netnis22/project-alset/test 1/Road2.jpg

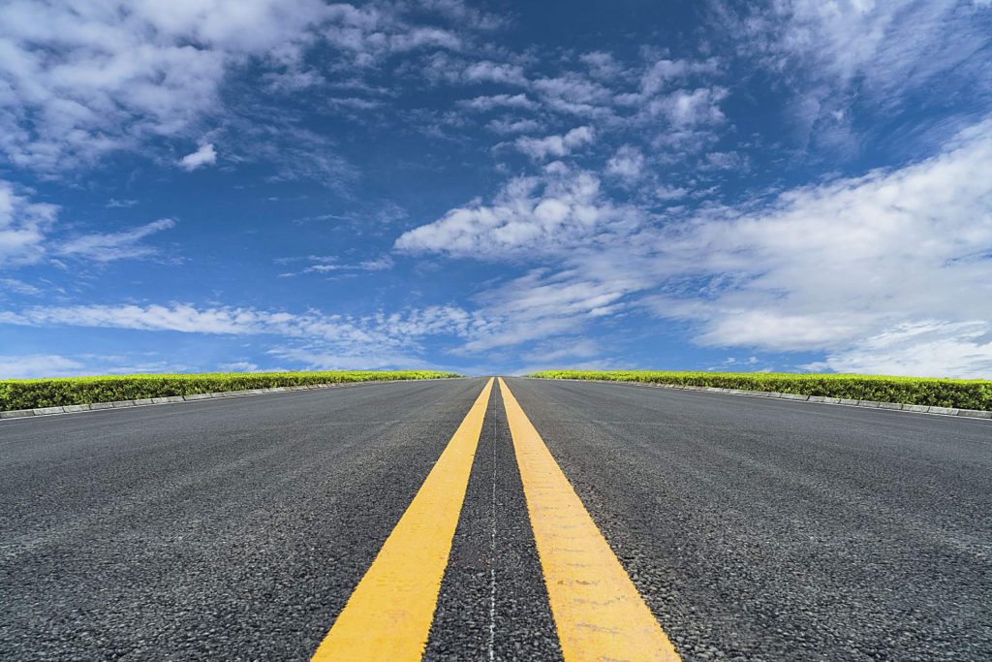
test 1/Road2.jpg
