netnis22/project-alset/test 1/imgRoodP.jpg

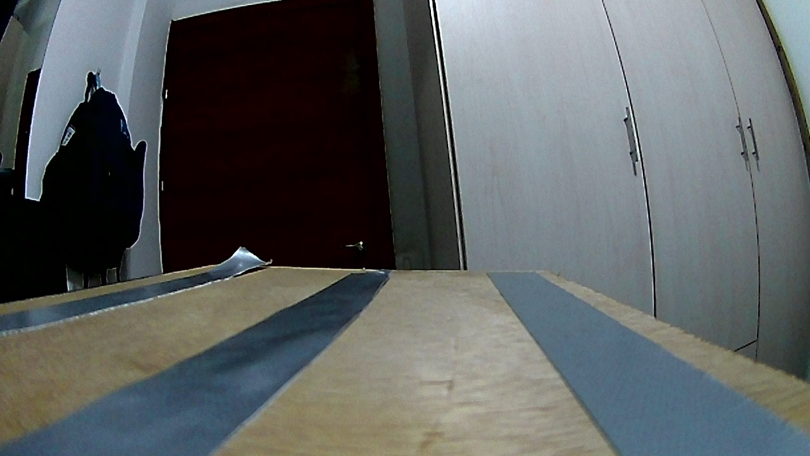
test 1/imgRoodP.jpg
