netnis22/project-alset/ספר פרויקט.pdf

# הלסט - alset

## שם בית ספר: אורט רבין גן יבנה שם המנחה: משה זזק שם החלופה: הגנת סייבר

## מגישים: נתנאל חכמון324199504- אייל גלם325754919-תאריך הגשה8/6/2021:

# תוכן עניינים

תקציר | 2..

## מבוא | 3-5 ארכיטקטורה | 6-11

מדריך למשתמש | 12-16.
מדריך למפתח | 17-34....
רפלקציה נתנאל | 35..
רפלקציה אייל | 36.
ביבליוגרפיה | 37...
נספחים | 38-52..

# תקציר

הפרויקט שלנו הוא דגם של מכונית אוטונומית המשלבת אלקטרוניקה,פיזיקה,מכניקה ותוכנה. מטרת הפרויקט היא לזהות את השוליים של הכביש ולתת פקודה לרכב לנוע בכיוון של הכביש בלי סטיה מהמסלול.

בספר זה אנו נסביר על הפרויקט , על אך הוא עובד , על האלקטרוניקה שלו, על המחשבה של איך ליבנות פיזית את הרובוט, על כל החישובים הפיזיקליים, על האלגוריתם של המציית השוליים של הכביש, על התקשורת בין החלקים השונים ועל הסיבה שבגללה בחרנו בפרויקט זה.

# מבוא

ספר זה מורכב מכמה חלקים חלק ראשון תקציר אשר מטרתו היא להסביר בקצרה על הספר ועל הפרויקט.

חלק שני הוא המבוא שבחלק זה אנו מרחיבים את אמירותיו בתקציר בנוסף לכך אנו מוסיפים את תהליך המחקר של הפרויקט,האתגרים שהיו לנו בפרויקט ופתרונות לבעית הללו.

חלק שלישי הוא הארכיטקטורה ששם אנו מסבירים על הפרויקט עצמו לעומק, מציגים את הפתרון הסופי שבו השתמשו למציאת הבעיה שמוזכרת במבוא, את הארכיטקטורה של הפתרון, בחלק זה אנו גם מסבירים גם על כל חלק אלקטרוני ברובוט ומה תפקידו, שרטוטים של האלקטרוניקה , נסביר גם על הקוד שכתבנו למציאת השוליים, נסביר על הספריות שהשתמשו בהם, נסביר על הקוד של הרובוט ועל הקוד השולט ומתרגם את המידע מהקוד של המציאת שולים, נסביר על התקשורת בין חלקים שונים של הרובוט כגון)התקשורת של רוזברי פי עם הארדרואינו( וכולי..

חלק רביעי הוא מדריך למשתמש ששם נדבר למשתבש איך להשתמש בפרויקט ואיך להפעיל ולהדליק את הפרויקט, נדבר על אך המשתמש יודע אם הפרויקט עובד כרעוי, נדבר על האפליקציה שמשתמש יצטרך להפעיל, נדבר על איך להתחבר לרובוט ולהזיז אותו ידנית ונדבר על האינדיקציות שהמשתמש צריך לשים לב אליהם.

חלק חמישי הוא מדריך למפתח שבו אנו נדבר הקבצים של הפרויקט על מיקומם בפרויקט, הסברים של פונקציות ומשתנים הנמצאים בקוד של הפרויקט, הסבר על איך לשנות או להוסיף דברים למעגל החשמלי של הרובוט, על המגבלות של הפרויקט והסבר על איך לערוך קבצים של הפרויקט.

מטרת הפרויקט היא לחקור ולהבין מקרוב את רעיון המכונית האוטונומית, ולאחר מכן ליצור דגם מוקטן של מכונית או רובוט אשר יוכל לפעול בצורה אוטונומית)חלקית( בהתאם לסביבה שנתנו לרובוט ללא עזרה מהמפעיל. חשבנו על פרויקט זה בגלל שהשימוש של מכוניות אוטונומיות הולך וגדל ורצינו לדעת איך הם עובדות ומה האתגרים שהם צריכים לעבור מבחינה של תוכנה ומבחינה של חשמל ואלקטרוניקה.

הרעיון של מכוניות אוטונומיות נמצא בשוק כבר מספר שנים כאשר מטרתם למזער את השתתפות האדם בנהיגה ובכך למזער את כמות התאונות וליצור כלי נוח ומדויק יותר לשימוש. מכוניות אוטונומיות כיום קיימות 6 רמות מרמה 0 לרמה 5 אך בשוק קיימות רק מכוניות עד רמה 4 כאשר המשמעות שלה היא שהנהג יכול אף לישון במהלך הנהיגה והמכונית תוכל לפעול לבד בשעת סכנה אך מגבלה חוקית לא מאפשרת למכוניות אלו לפעול בכל מקום ומחייבות אפשרות התערבות אנושית בנהיגה.

רמה 5 היא הרמה הגבוהה ביותר של אוטונומיות שניתן להעניק לרכב ומשמעותה שהמכונית לא צריכה שום התערבות אנושית אף אל פי השוק הרחב רכבים אלו עדיין לא נמצאים חברות רבות מנסות לעבור אתגר זה ואחת מהן היא טסלה אשר היום מייצגת אחת מהחברות המובילות ביותר בתחום טכנולוגיית המכוניות האוטונומיות.

הפרויקט שאנו בנינו אמור לדמות מכונית אוטונומית שמזה את השוליים של הכביש ובצורה אוטונומית שולטת ברכב ומתקנת אותו ומחזירה אותו למסלול. חלק מהפרויקט הוא התוכנה וחלקו השני הוא החומרה והאלקטרוניקה והפתרון שהוא אמור לתת זה חקירה של מכוניות אוטונומיות ועיבוד תמונה.

האתגרים הניצבים בפנינו הם כך:

1( איך לזהות את השוליים של הכביש מוידאו חיי. 2( איך להעביר את המידה הזה לרובוט ולתרגם אותו לפעולה שהרובוט יעשה ויגרום לו לזוז. 3( איך להשאיר את הרובוט במהירות קבוע. 4( איך ליבנות את הרובוט.

הפתרונות לבעיות הללו:

1[ שימוש בעיבוד תמונה והספריות אשר נקראות opencv שמטרתם היא להקל על המתכנתים שהם לא יתחילו מאפס אלה בספריה בנויות פונקציות אשר נותנות לנו לדאוג רק ליצירת האלגוריתם והפונקציות של עיבוד התמונה בלי להתעסק במתמטיקה והתרגום וידאו לשפה שהמחשב יבין. ספריה זו ניתנת לשימוש בסוגי שפות תכנות שונות אנחנו בחרנו להשתמש בפייתון בגלל ההיכרות שלנו עם השפה. המחשב אשר עושה את החישובים הללו ברובוט הוא ה PI Raspberry או בקיצור

RP אנחנו נשתמש בקיצור זה בספר זה במקום ב שם PI Raspberry.

2[ בשביל להעביר את מידה זה אנו השתמשנו בRP וב arduino שהוא מיקרו-בקר בעל מעגל מודפס יחיד אשר מטרתה ליצור סביבה נוחה וזולה לפיתוח פרויקטים המשלבים תוכנה עם רכיבי אלקטרוניקה. והעברנו מידה בכך שחיברנו כבל בין ה RP וה arduino והעברנו את המידה עם הפורטים והפרוטוקולים שלהם. מי שתרגם את זה הוא ה arduino והוא הפך את הקוד למידע אשר המנועים והבקרים יכולים להבין.

3[ כדי שהרובוט ישאר במהירות קבוע אנחנו משתמשים בפונקציות אשר משתמשות בשיטת הpid אשר לוקחת מהירות ושגיעות של הרובוט ומתקנת אותה כדי שהרובוט לא ינוע במהירות אשר אנו לא רוצים.

4[ בשביל לבנות את הרובוט אנחנו שרטטנו סקיצות של הלוחות חשמל והשתמשנו בסימולציות כדי לבדוק אם האלקטרוניקה עובדת לפני בנייתה. אחר כך אנחנו הרכבנו את האלקטרוניקה ובדקנו שזה עובד ואז חיברנו את האלקטרוניקה לשלדה של הרובוט.

# ארכיטקטורה

הפרויקט שלנו מביא את הפתרון שמוזכרת במבוא לידי ביטוי, בכך מפחית מצבי נהיגה מסוכנים על ידי שמירת נתיבים. הרובוט מקבל תמונה בעזרת המצלמה והיא עוברת עיבוד בעזרת הקוד שכתבנו בתוכנה . לאחר מכן הוא מקבל החלטה האם הרובוט נוסע במצב הנכון ובתוך הנתיבים , אם לא הרובוט אמור לסטות ימינה או שמאלה בהתאם למה שהוא רואה . בכל רגע נתון מתקבלת תמונה חדשה ואם הוא רואה איזה שינוי הוא יודע מה לעשות. לדוגמא, הרובוט יודע לזהות פניות חדות ולהתאים את המהירות לפי זה.

תהליך העבודה על הפרויקט התחיל ממספר שרטוטים בסיסיים אשר עזרנו לנו להבין כיצד לעצב את הקוד. מכיוון שהפרויקט שלנו הוא פיזי ומכיל בתוכו רכיבים אלקטרוניים התחלנו עם שרטוט אשר מכיל את כל הרכיבים אשר יהיו חלק מהפרויקט שלנו. חלק זה כולל את הרכיבים האלקטרוניים שרטוט מופשט של הRP שמפעיל את הרובוט ושרטוט של מבט על של הפרויקט.

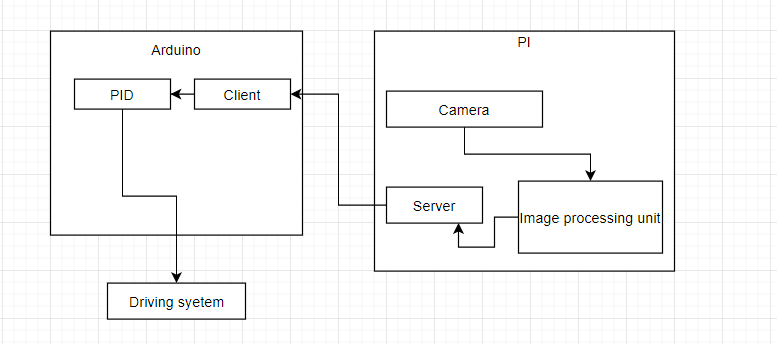
[picture p15: figure]

)השרטוט הראשוני של מבט על של פרויקט(

לאחר מכן התחלנו לפרק כל חלק מהרכיבים המופשטים למספר סקריפטים שיבצעו חלקים שונים

מהעבודה הכוללת. תרשים זה היה יותר מפורט, הוא כלל הסבר על כל חלק ויכולנו להשתמש בו כדי

לתכנן מוחשית כל אחד מהסקריפטים בהם תכננו להשתמש בפרויקט זה.

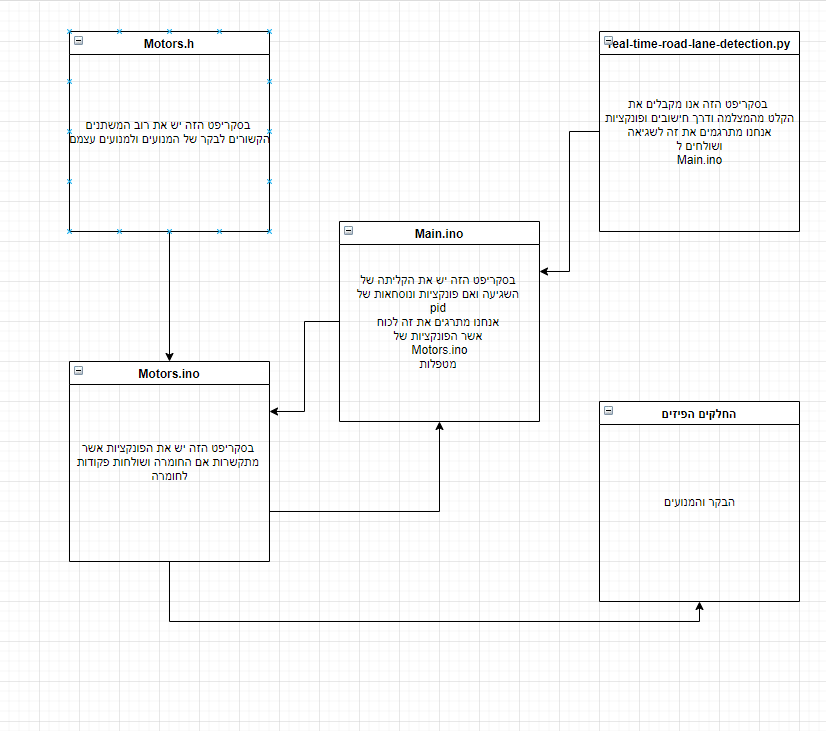
[picture p16: figure]

## האלקטרוניקה של הפרויקט:

הרכיבים האלקטרונים שהשתמשנו בהם בפרויקט הם:

.1 רזברי פי -3 מחשב - לוח יחיד בגודל כרטיס אשראי שבעזרתו בפרויקט אנו מעבדים את התמונה .
.2 בקר -לוח חשמלי שמטרתו היא לקבל נתונים ולהפוך אותם לזרמים חשמליים ששולטים במנוע
.3 מצלמה - בעזרת המצלמה מחוברת אל הרזברי פי אנחנו מזהים את הנתיבים. .4 סוללות נטענות - בעזרת הסוללות אנחנו יכולים להפעיל את המנועים והמאוורר. .5 סוללה נטענת נוספת- הסוללה מספקת חשמל על הרזברי פי .6 מטריצה- מחברת בין כל האלקטרוניקה בפרויקט. .7 ארדואינו- הוא מיקרו-בקר בעל מעגל מודפס יחיד, עם סביבת פיתוח משולבת ברישיון קוד פתוח, אשר מטרתה ליצור סביבה נוחה וזולה לפיתוח פרויקטים המשלבים תוכנה עם רכיבי אלקטרוניקה.

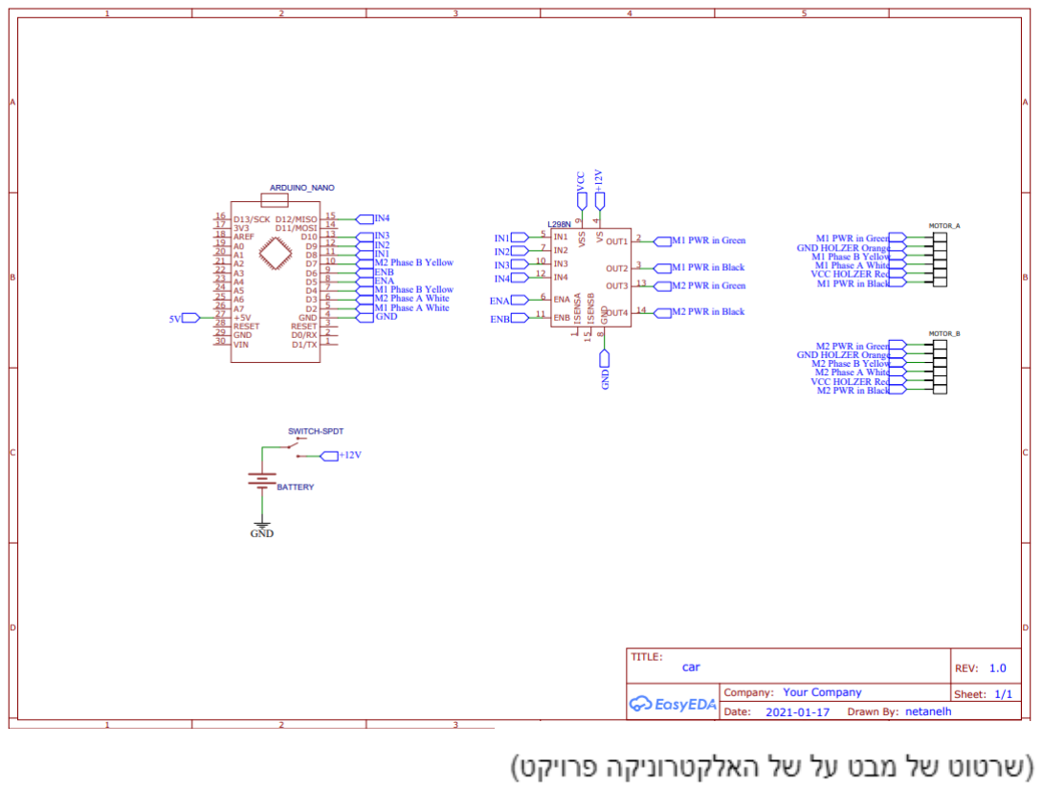
[picture p17: figure]

# היחידות המרכיבות את הפרויקט

:Road_line_detection
יחידה זו מקבלת תמונה סטטית של הכביש ומוצאת את גבולות הכביש. גבולות הכביש נמצאים בעזרת מספר פילטרים שהתמונה עוברת דרכם. ראשית אנחנו מסננים את כל האיברים בתמונה שהם אינם אפורים)הסימון שלנו לגבולות הכביש( ,לאחר מכן אנחנו משתמשים בטכנולוגיית Edge detection של ספריית OPENCV של פייטון כדי למצוא את כל האיברים האפורים בתמונה המייצגים קו ישר או חלק מקו ישר. אחר כך אנו קובעים לתמונה interest of reign ומסננים את כל מה שלא נמצא בתוך זה.

לאחר שמצאנו את גבולות הכביש אנו נבדוק את המיקום היחסי של המכונית ביחס לכביש על ידי החישוב נקודה שהיא אמצע הכביש על ידי נוסחה הנקראת distance ונחסר ממנו את הנקודה שהיא האמצע של המכונית. כאשר מצאנו את המיקום היחסי אנחנו משתמשים בו לשני פונקציות שונות אחת אשר הופכת את המיקום היחסי למשתנה שמשמעותו היא התיקון שהמכונית צריך לעשות במהירות הסיבובית והמשתנה הוא כל מספר )גם מספר ממשי( בין -1 ל .1 והשניה היא פונקציה אשר קובעת את המהירות הקווית של המכונית והיא עובדת כך שאם אנו נמצאים באמצע של הכביש או שאנו קרובים לאמצאה אז המשתנה של המהירות הקווית היה 10 ואם המכונית לא רואה לפחות קו אחד אז המשתנה של המהירות הקווית היא 0.

תקשורת בין ארדואינו ל rp:
בחלק זה יש את הצד של הארדרואינו ואת הצד של ה rp והמטרה היא ליצור תקשורת פרוטוקול רציפים ומהירים.

צד של הארדואינו:
קלט-מהירות קווית ומהירות סיבובית)בתור משתנה אחד שהארדואינו מתרגם על ידי פונקציה שבנינו(.
פלט-אין.

צד של הrp:
קלט-אין.
פלט- מהירות קווית ומהירות סיבובית)בתור משתנה אחד שהrp עושה לו encode).

לאחר כך אנו יצרתו תרשים המתאר את התקשורת ביניהם:

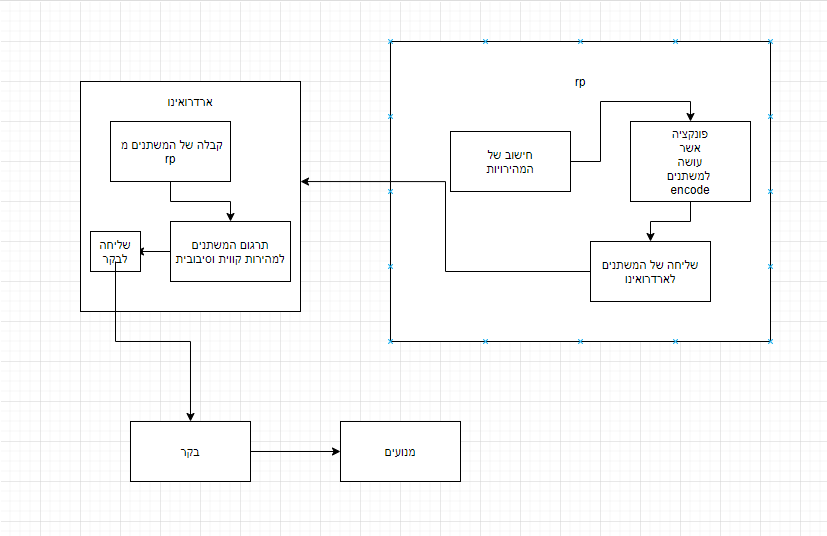
[picture p18: figure]

PID-Proportional-Integral-Derivative

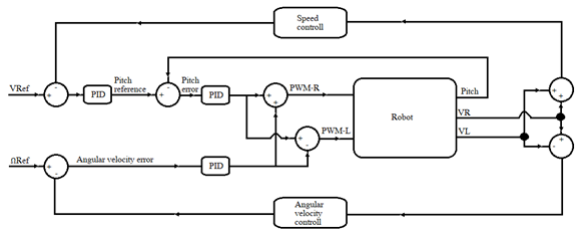
[picture p19: figure]

PID זה בעצם דרך לשלוט על המהירות של המנועים והמטרה שלה היא מניעת שגיאות וסטיות שהרובוט יכול לבצעה. בPID אנו לוקחים את השגיאה מחשבים אותה ומחברים אותה אם הנגזרת שלה והאינטגרל שלה.
אנו משתמשים במערכת כדי שהרובוט לא יסטה מהמסלול בכך שהמהירויות שאנו אומרים לו הם לא נכונות בגלל שיש שגיאה בגלל כל מיני פרמטרים כמו זמן מרחק וחיכוך. את השגיאה אנו מקבלים מ החלק של הdetection_line_Road והארנרואינו מחשב מתקן את השגיאה ושולח את המהירות הסופית לרובוט. בפרויקט שלנו יש שני PID אחד אשר שייך למהירות הקווית והשני אשר שייך למהירות סיבובית.

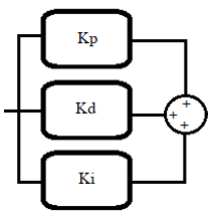
[picture p20: figure]

# מדריך למשתמש

ראשית לפני ההפעלה יש לוודא שה RP מחובר למטען נייד ושהארדרואינו מחובר ל RP ויש לוודא שהמצלמה מחוברת והרובוט נמצא בתוך המסלול. כדי להפעיל את הרובוט צריך להדליק את המטען הנייד ולחבר את הסוללות האדומות. פעולה זו תדליק את ה RP הארדרואינו ואת המנועים. בשביל להריץ את הקוד של הפרויקט נצטרך לשלוט על ה RP מרחוק נוכל לעשות זאת נצטרך את האפליקציה Viewer VNC.

מדריך להורדת ותפעול Viewer VNC

ראשית נכנס לאתר שלהם מהקישור הבא: /https://www.realvnc.com/en/connect/download/viewer

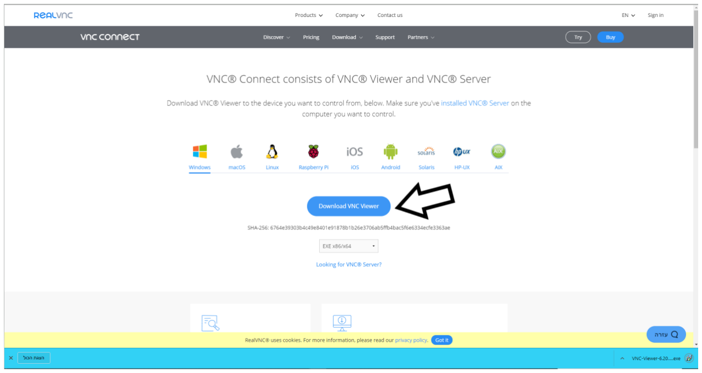
[picture p21: figure]

ונוריד את האפליקציה כך:
אחרי זה מתקינים את התוכנה עוקבים אחרי ההנחיות הבאות:

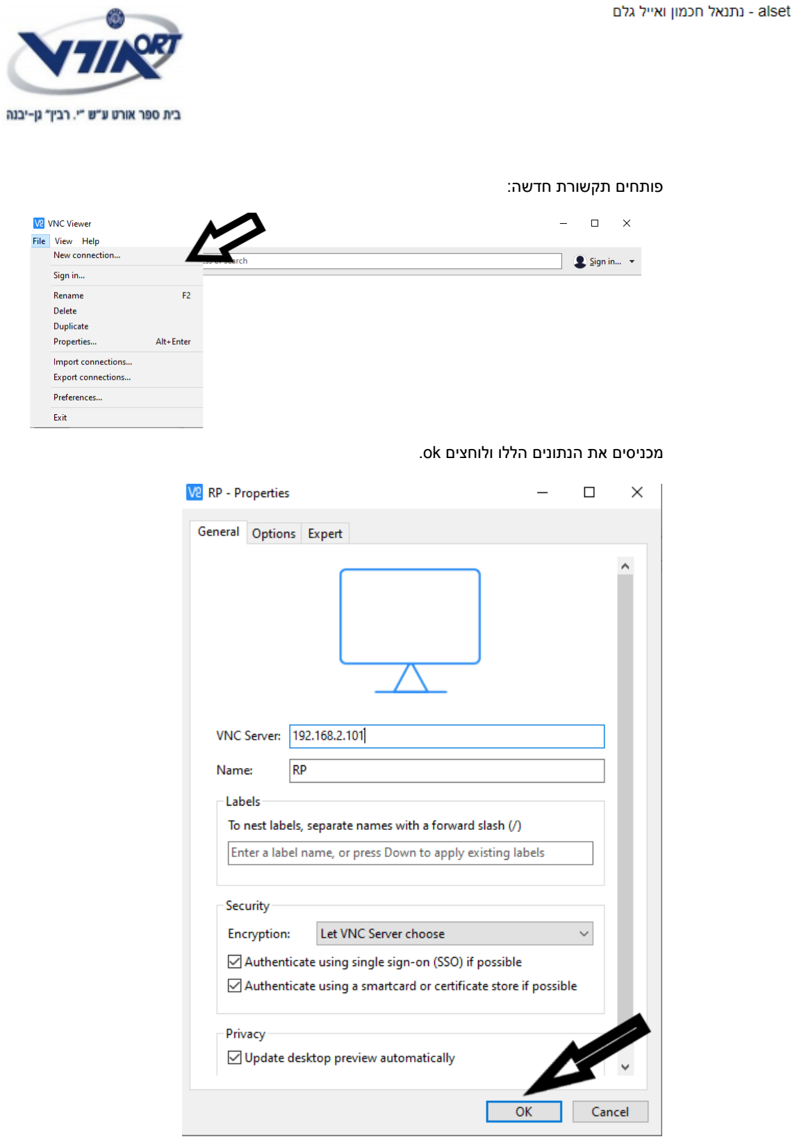
[picture p22: page 14]

פותחים תקשורת חדשה:

מכניסים את הנתונים הללו ולוחצים ok.

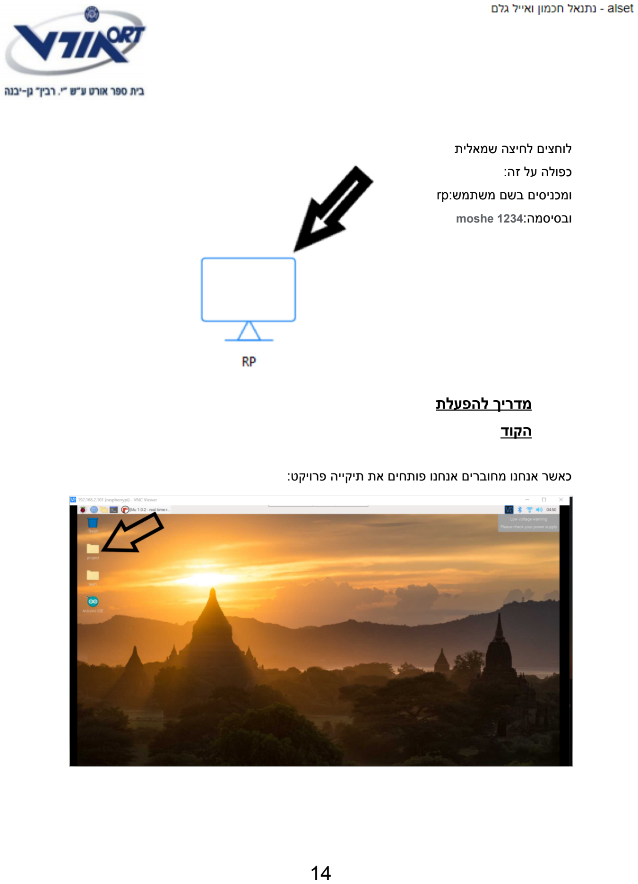
[picture p23: page 15]

לוחצים לחיצה שמאלית
כפולה על זה:
ומכניסים בשם משתמש:rp

ובסיסמה1234: moshe

מדריך להפעלת
הקוד

כאשר אנחנו מחוברים אנחנו פותחים את תיקייה פרויקט:

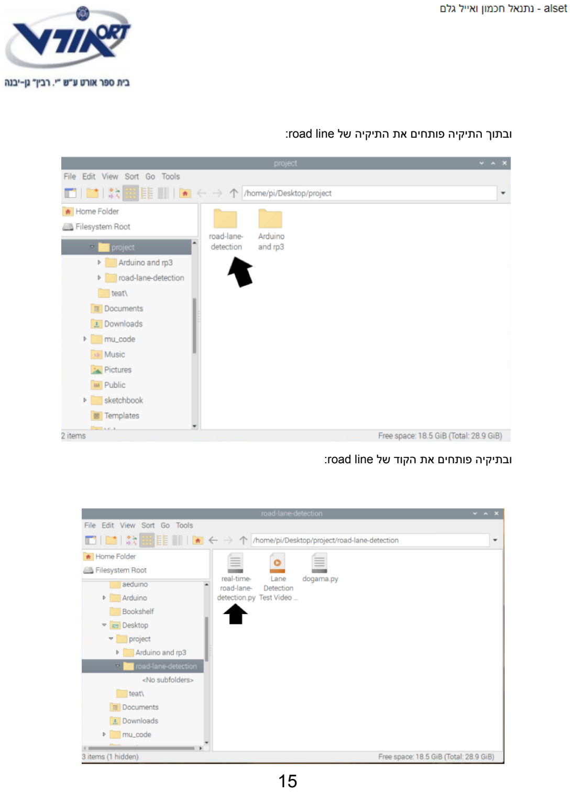
[picture p24: page 16]

ובתוך התיקיה פותחים את התיקיה של line road:

ובתיקיה פותחים את הקוד של line road:

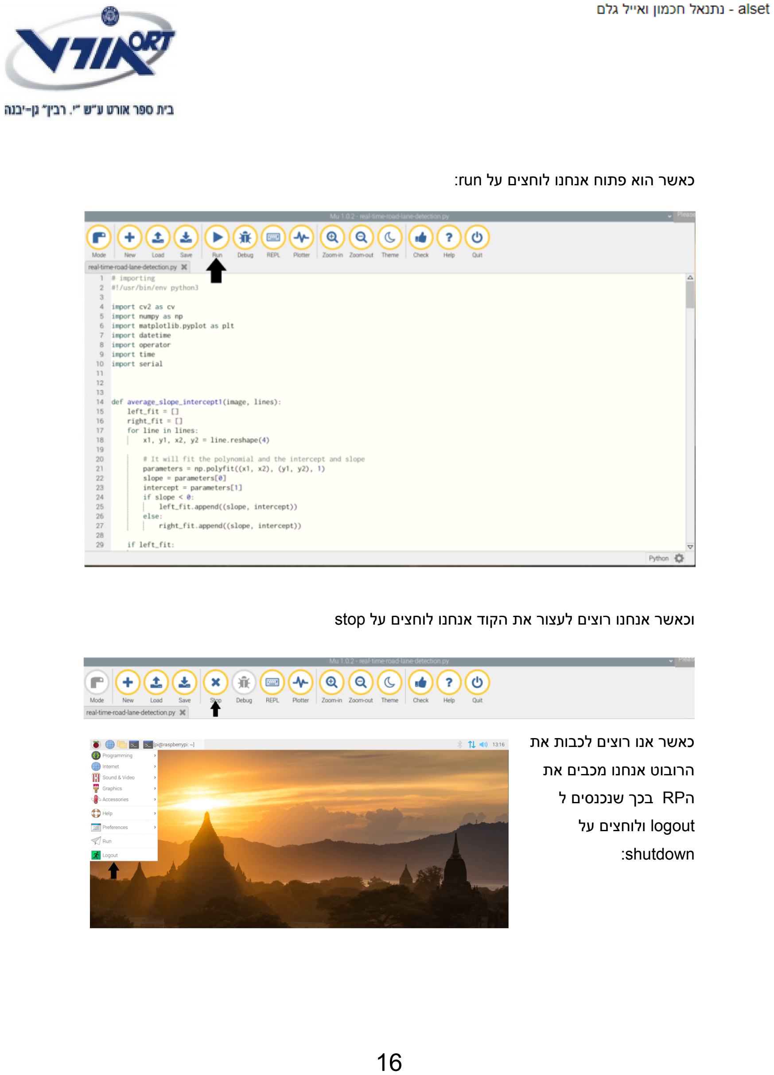
[picture p25: page 17]

כאשר הוא פתוח אנחנו לוחצים על run:

וכאשר אנחנו רוצים לעצור את הקוד אנחנו לוחצים על stop

כאשר אנו רוצים לכבות את
הרובוט אנחנו מכבים את
הRP בכך שנכנסים ל
logout ולוחצים על
:shutdown

# מדריך למפתח

כל הקבצים שלנו נמצאים בתיקיות:
1) /home/pi/Desktop/project/road-line-detection
2) /home/pi/Desktop/project/Arduino and rp3/Main2 הפרויקט מכיל 4 קבצים שהם:
real-time-road-lane-detection.py
Main.ino
Motors.h
Motors.ino

### ארדואינו והפעלת מנועים

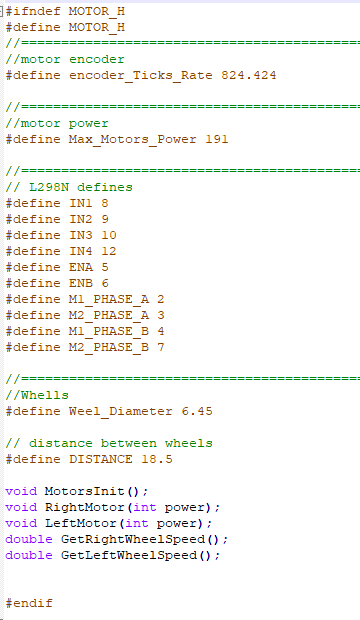
[picture p26: figure]

על הארדואינו יש את מחלקת motors .האחראית על לשלוח את הערכים המתאימים למנועים של הרובוט ובנוסף לכך בארדואינו נמצא הקובץ main נמצאת הלולאה הראשית של הארדואינו אשר מקבלת מספר מהRP המייצג את הפקודה ומבצע אותה על ידי שליחת מידע מתאים למנועים. בקובץ motors.h נמצאת הגדרת קבועים המייצגים את נקודות החיבור של החיישנים והמנועים עם הארדואינו אשר ישמשו אותנו מאוחר יותר כדי לשוח ערכים לרכיבים המתאימים. בנוסף לכך הוספנו קבוע המייצג את קוטר הגלגל ובמחלקה נמצאות פעולות השולחות מתח לגלגלים ) RightMotor ו LeftMotor) ופעולה המאתחלת את המנועים בתחילת
התוכנה)motorInit)

במחלקה motors ישנם מספר מישתנים ופונקציות אחת מהם היא GetRightWheelSpeed אשר מישתמשת בפונקציות הבאות שנדבר אילהם ומהנתונים של הפונקציות הללו היא מחשבת את המהירות של הגלגלים.

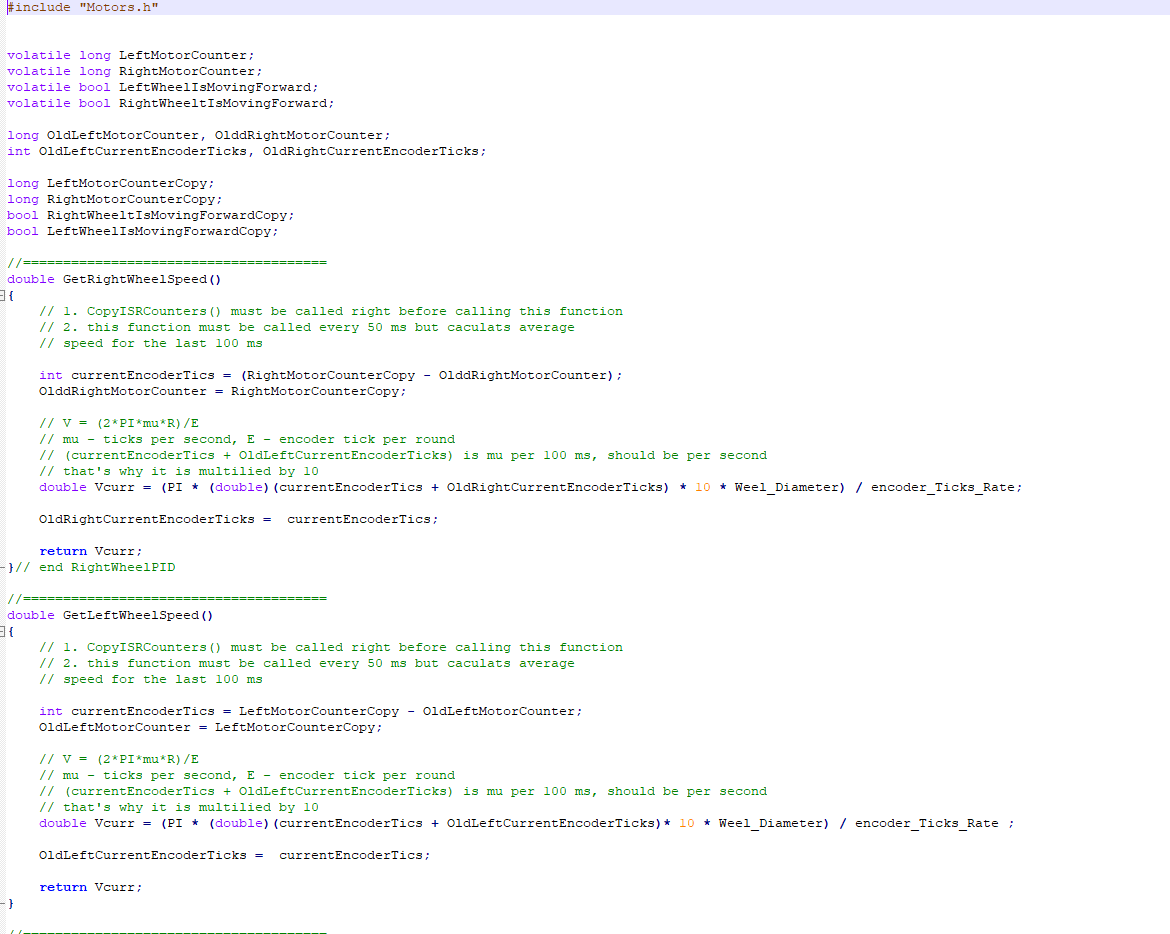
[picture p27: figure]

הפעולה
CopyISRCounters
מעתיקה את הערך
מהאינקודרים לעותקים
שלהם, פעולה זו תרוץ
בכל פעם שנרצה לבדוק
את ערך האינקודרים. יש
לשים לב כי פעולה זו
עוצרת את כל
האינטראפטים כלומר

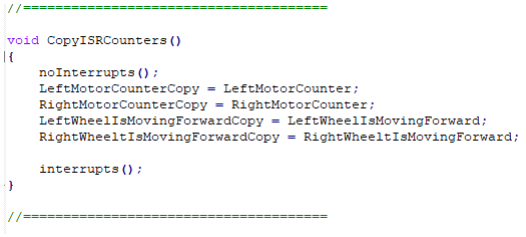
[picture p28: figure]

אינטראפט זו פעולה הדואגת למענה מהיר להתרחשויות שונות לדוגמא שינוי ערך האינקודר , כלומר עצירת האינטראפטים גורמת לכך שחיישן האינקודר לא ישנה את ערך המשתנים שלו כלומר בהעתק של המשתנים יהיה הערך המעודכן ביותר לאחר מכן האינטראפטים חוזרים לפעולה בסיום פעולה זו.

הפעולות LeftEncoderISR ו RightEncoderISR אחריות לעדכן את משתני האינקודרים בהתאם. אם הרובוט נא קדימה המשתנים גדלים בהתאם אם הרובוט נע בכיוון ההפוך המשתנים יקטנו. פעולות אלו יחוברו לאינקודרים בתור אינטראפטים אשר יתרחשו בעת שינוי ערך האינקודרים.

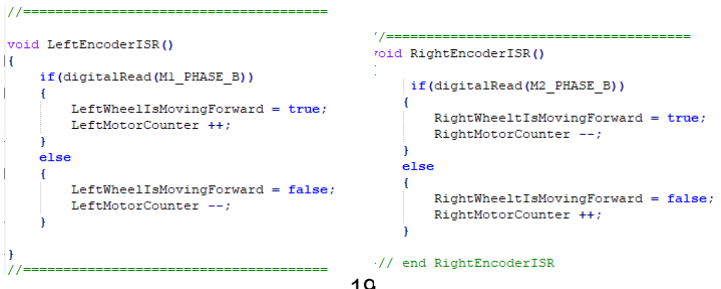
[picture p29: figure]
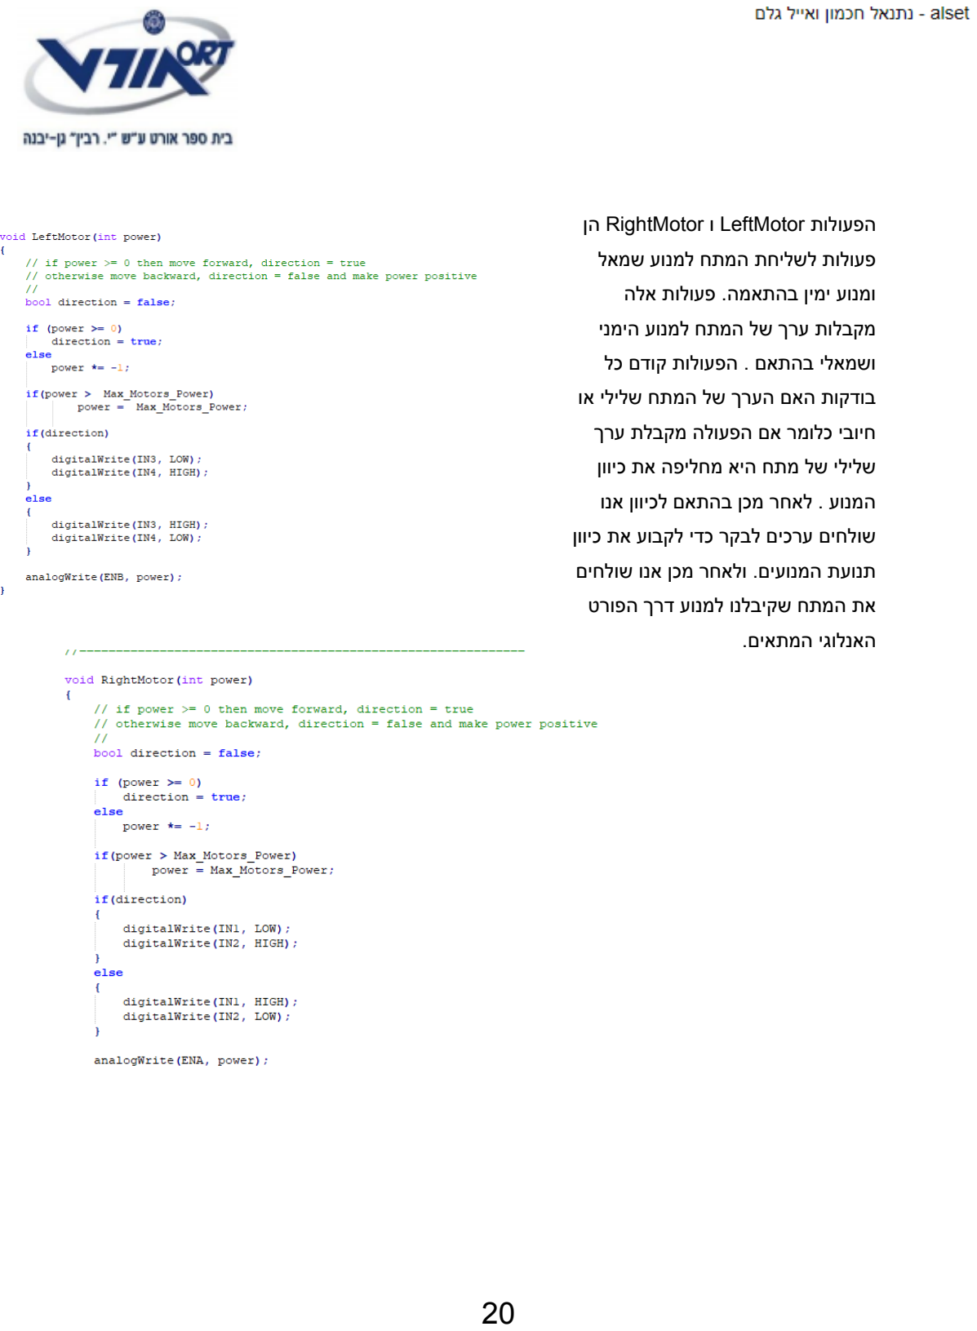
[picture p30: page 21]

הפעולות LeftMotor ו RightMotor הן פעולות לשליחת המתח למנוע שמאל ומנוע ימין בהתאמה. פעולות אלה מקבלות ערך של המתח למנוע הימני ושמאלי בהתאם . הפעולות קודם כל בודקות האם הערך של המתח שלילי או חיובי כלומר אם הפעולה מקבלת ערך שלילי של מתח היא מחליפה את כיוון המנוע . לאחר מכן בהתאם לכיוון אנו שולחים ערכים לבקר כדי לקבוע את כיוון תנועת המנועים. ולאחר מכן אנו שולחים את המתח שקיבלנו למנוע דרך הפורט האנלוגי המתאים.

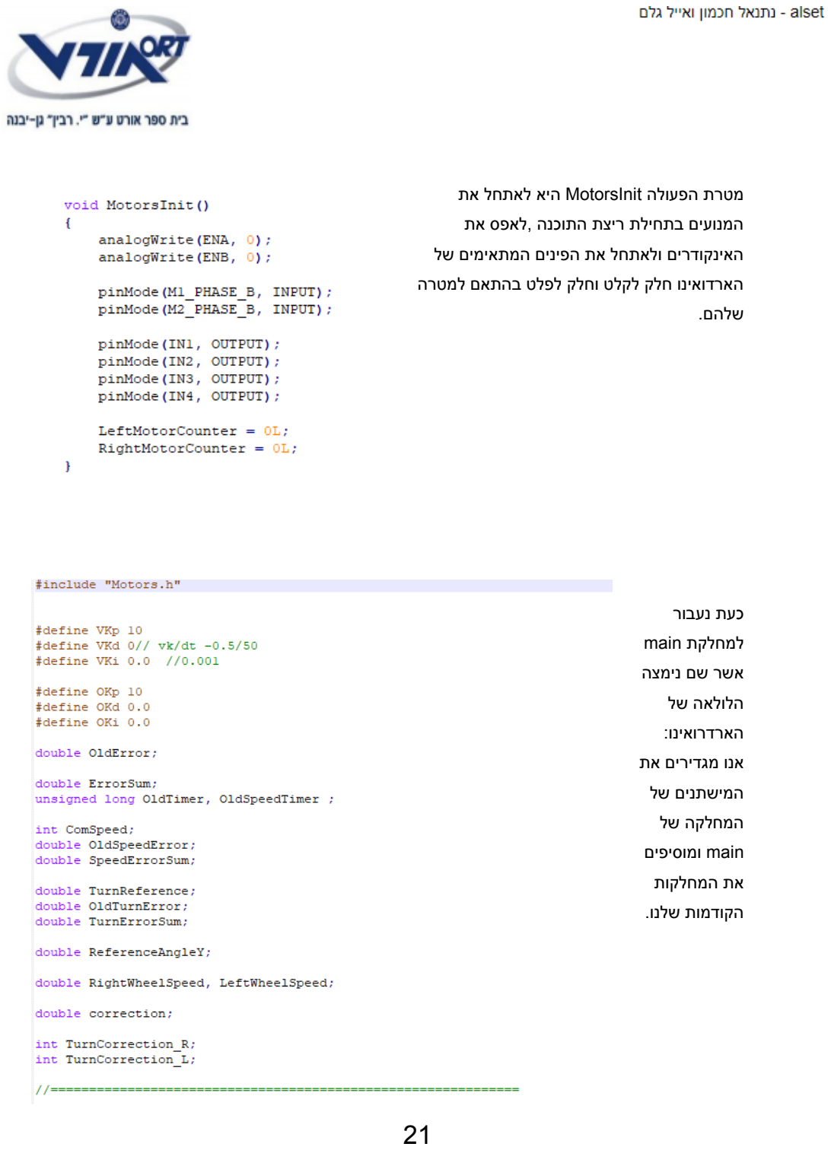
[picture p31: page 22]

מטרת הפעולה MotorsInit היא לאתחל את המנועים בתחילת ריצת התוכנה ,לאפס את האינקודרים ולאתחל את הפינים המתאימים של הארדואינו חלק לקלט וחלק לפלט בהתאם למטרה שלהם.

כעת נעבור
למחלקת main
אשר שם נימצה
הלולאה של
הארדרואינו:
אנו מגדירים את
המישתנים של
המחלקה של
main ומוסיפים
את המחלקות
הקודמות שלנו.

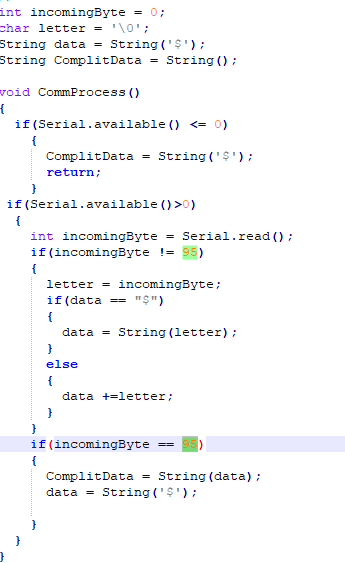
[picture p32: figure]

הפעולה commProcess )(היא פונקציה שמטרתה היא לתקשר עם ה RP ואם היא הצליחה לתקשר אז היא לוקחת את המידע שהיא קיבלה מ RP ומכניסה אותו)את המידע שהוא char )למחרוזת data וכאשר היא מקבלת את המידע האסקי 95 שזה)"_"( אז אנו שומרים את המחרוזת data במחרוזת אחרת בשם ComplitData ומאפסים את מחרוזת של data לסימן .$ סימן ה $ זה הסימן הקבוע שבחרנו בו כדי לייצג את המחרוזת בתור מחרוזת ריקה.

הפונקציה Translation מתרגמת את המחרוזת ComplitData לפי הפרוטוקול הבא: יש שני משתנים אחד למהירות סיבובית ואחד למהירות קווית לפי הפרוטוקול כאשר אנו מקבלים את המחרוזת )x-מספר בין ,0-20y-מספר בין 1 ל -1( VxTy אז הV מסמן שהמספר x הוא מהירות קווית וה T מסמל שזה מהירות סיבובית. כאשר תירגמנו אז המהירות הקווית נכנסת למשתנה )מסוג int )בשם ComSpeed המהירות הסיבובית נכנסת למשתנה )מסוג double )בשם .TurnReference

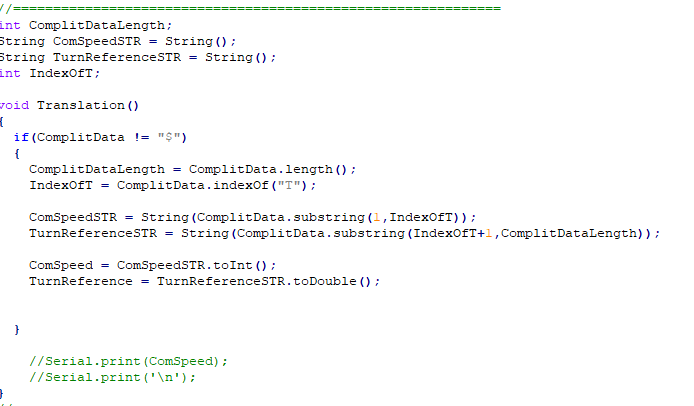
[picture p33: figure]
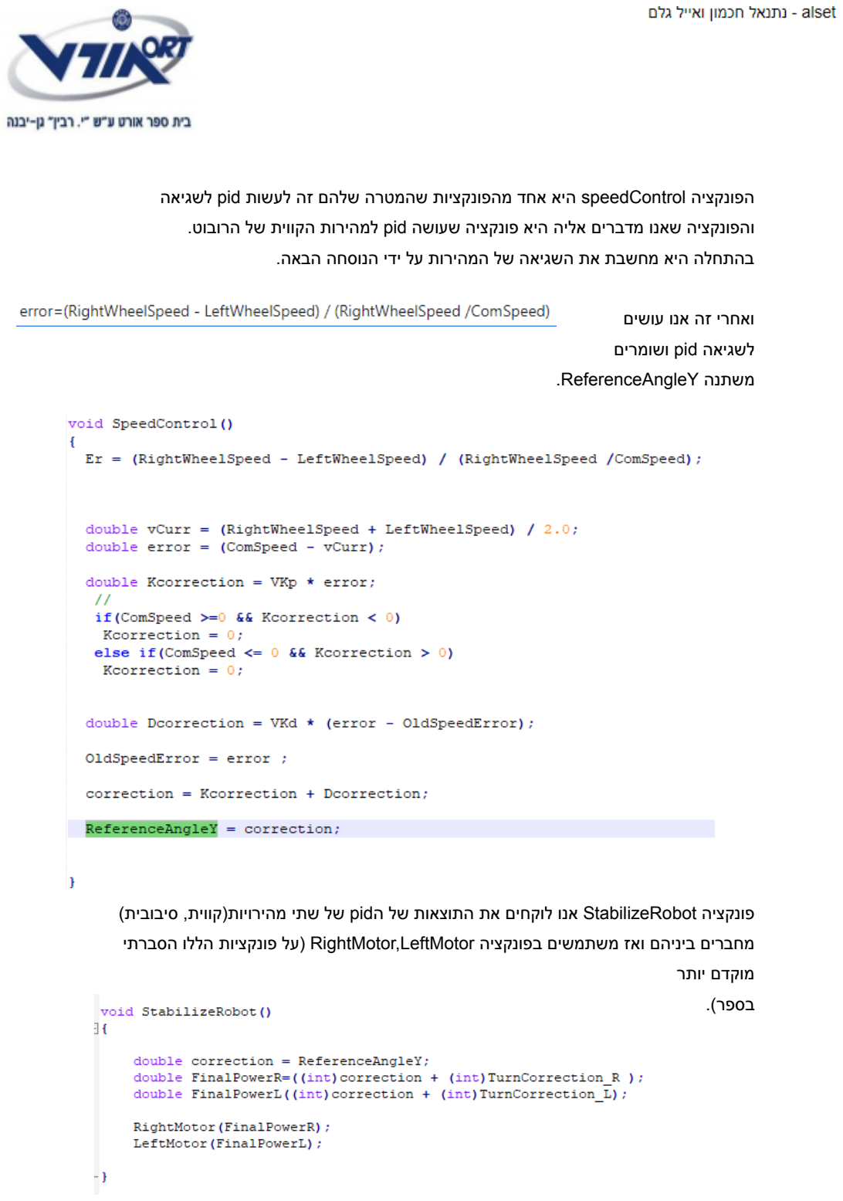
[picture p34: page 25]

הפונקציה speedControl היא אחד מהפונקציות שהמטרה שלהם זה לעשות pid לשגיאה והפונקציה שאנו מדברים אליה היא פונקציה שעושה pid למהירות הקווית של הרובוט. בהתחלה היא מחשבת את השגיאה של המהירות על ידי הנוסחה הבאה.

ואחרי זה אנו עושים
לשגיאה pid ושומרים
משתנה ReferenceAngleY.

פונקציה StabilizeRobot אנו לוקחים את התוצאות של הpid של שתי מהירויות)קווית, סיבובית( מחברים ביניהם ואז משתמשים בפונקציה LeftMotor,RightMotor( על פונקציות הללו הסברתי מוקדם יותר
בספר(.

פונקציה setup היא הפונקציה הראשונה שתפעל כאשר אנו מדליקים את הארדרואינו והיא תופעל רק פעם אחת והמטרה שלה היא איפוס משתנים וקביעת משתנים ושימוש בפונקציות שמטרתם דומה. גם אנו קובעים שם משתנים שהם ברירת מחדל.

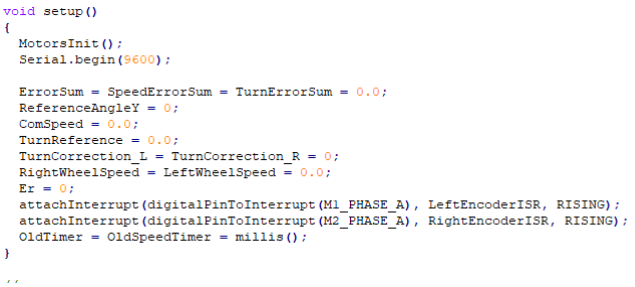
[picture p35: figure]

פונקציה loop היא הפונקציה החשובה ביותר בגלל שהיא הפונקציה פועלת אחרי setup והיא פועלת עד
שהארדואינו
מפסיק לקבל
חשמל.
בפונקציה
הזות אנו
משתמשים
בכל
הפונקציות
האחרות.

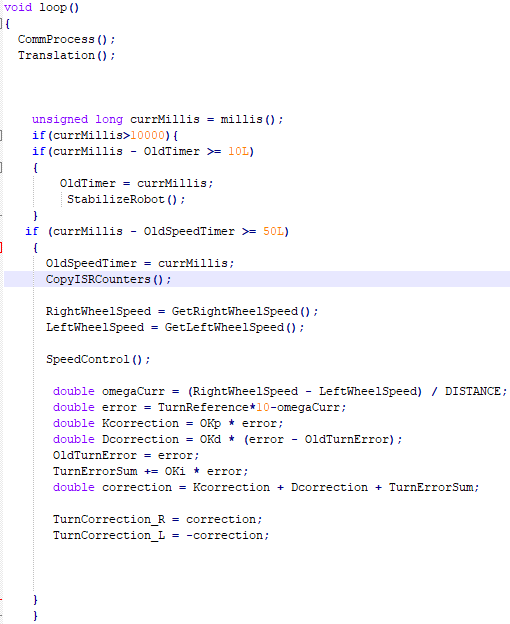
[picture p36: figure]

תחילה אנו משתמשים בתקשורת והתרגום כדי לקבל ולתרגם את המידע.

אחר כך אנו בודקים האם עברו 10000 מילישניות אם כן אז אנו מפעילים את הפונקציה StabilizeRobot.

אנו גם בודקים עם עברו 50 מילישניות ואם כן אז הרובוט מפעיל את הפונקציות שמטרתם היא לחשב את המהירות והוא גם
מפעיל את הפונקציה
SpeedControl. הוא גם עושה
pid למהירות סיבובית ושומר את התוצאות במשתנים:
TurnCorrection_R,
.TurnCorrection_L

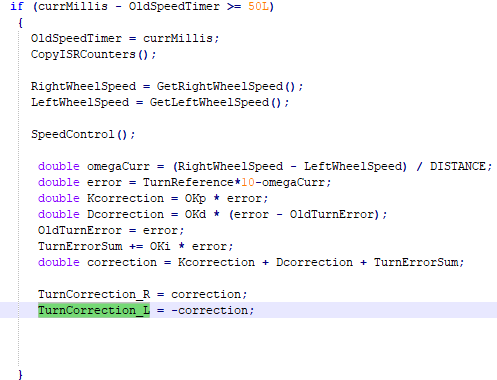
[picture p37: figure]

הפונקציה loop פועלת כך בגלל שכול 50 מילישניות הוא מחשב ועושה pid למהירויות וכל 10000 מילישניות הוא משתמש במהירויות ומזיז את הרובוט)בשימוש בפונקציה StabilizeRobot )לפי זה.

### עיבוד תמונה זיהוי שוליים של הכביש

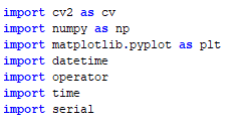
[picture p38: figure]

real-time-road-lane-detection.py | שנקרא | קובץ | יש RPה על
והמתרה שלו היא עובוד תמונה זיהוי שולים ותיקשורת עם הארדרואינו.
תחילה אנו מוסיפים את הספריות שבהם אנו נשתמש. 2cv או opencv זה ספריה לעיבוד תמונה numpy זה ספריה לפעולות מתמטיות שאר הספריות הם לשימושים כמו זמן תקשורת והצגת תמונה.

פעולה infroCam היא בשביל שנקבל ונישמור נתונים של המצלמה כמו רזולוציה, כמות תמונות בשנייה. וגם אנו מוסיפים את הנתונים הללו כטקסט על המצלמה.

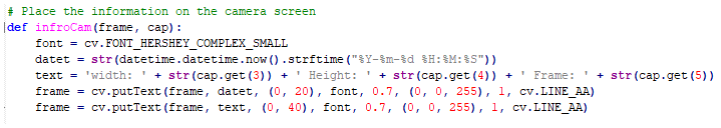
[picture p39: figure]

פעולה infrocamPrint היא בשביל המפתח והיא מדפיסה את האינפורמציה של המצלמה.

בפעולה makeMask אנו מיצרים את הפילטר שיסננן את הצבעים וישאיר רק את הצבע של הקויים. אנו גם קובעים את הצבע שהוא יחפש שבמיקרה זה הוא הקויים.

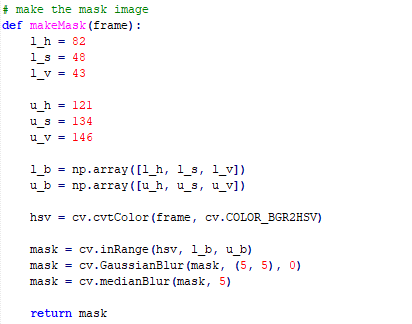
[picture p40: figure]

בפעולה showImages אנו מציגים במסך את הוידאו של המצלמה בכמה מצבים שחלק מהם היא אם הפילטר בלי הפילטר ואחרי זיהוי הקווים.

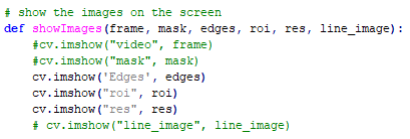
[picture p41: figure]

פעולה breakLoop אחראית על סיום לולאה בפונקציה הראשית.

בפעולה interest_of_region אנו קובעים את אזור העניין של הזיהוי קווים כדי להקל על הRP וכדי שהפילטרים ועיבוד
תמונה לא יזהו דברים
ועצמים שלא שייכים
לכביש.

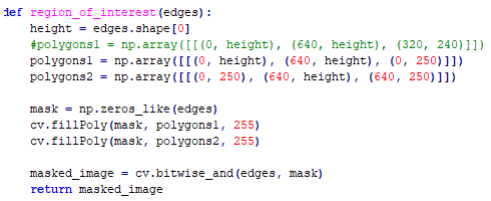
[picture p42: figure]

הפעולה coordinates_create מייצרת את הנקודות ציון של הקווים ושומרת אותם בתוך מערך של np.

הפונקציה midelOFaLine היא פונקציה שמטרתה היא למצוא את האמצע של הקו שהיא מקבלת היא עושה את זה על ידי השימוש בנוסחה :

ואז היא מחזירה את התוצאה בתור מחרוזת.

הפונקציה midelOfRode עושה את אותו הדבר אך במקום לקחת קו אחד היא לוקחת את שניהם ומחשבת את הנקודה שהיא האמצע של שני הקווים. ומחזירה את התוצאה בתור מחרוזת.

פונקציה errorTurn אנו מחשבים את השגיאה ואת המרחק בין נקודות ציון של midelOfRode ושל אמצע המסך וזה קדי להגיד לרובוט מתי הוא באמצע ומתי הוא קצת ימינה או שמאלה מאמצע הכביש. הוא עושה את זה בכך שהוא בודק אם הוא מוצא את קו שמאל וקו ימין אם כן אז הוא מחשב את אמצע הכביש לוקח את נקודת ה x שלה ומחסר אותה בנקודת ה x של אמצע המסך וכדי שזה היה בין 1 ל -1
אנו מחלקים
בנקודה x של
אמצע המסך. אם
אנו לא רואים את
קו ימין או שמואל
אז הטעות היא
מקסימלית ואנו
צרכים להחזיר 1
או -1 תלוי לי
איזה קו הוא לא
רואה. פונקציה
זה היא בשביל
המהירות
הסיבובית של
הרובוט.

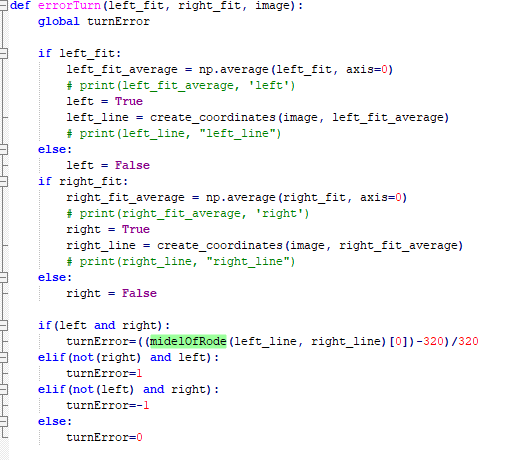
[picture p43: figure]

פונקציה checkAndPrint עושה את אותו עבודה כמו errorTurn אך היא עושה את זה למהירות הקווית בכך שאם היא לא רואה אף אחד מהקווים אז המהירות היא 0 והם היא רואה את שניהם אז היא בודקת אם הנקודת ציון בציר ה x של midelOfRode ובודקת אם היא בטווח של 30 pixel מאמצע המסך אם כן אז היא מחזירה למישתנה msg מהירות 10 ומוסיפה את זה כדי שזה יראה כמו בפרוטוקול תקשורת שעליו דיברנו לפני בארכיטקטורה אם הוא כן רואה את שני הקווים אך זה לא באמצע אז הוא עדין יחזיר למשתנה מהירות 10 ויוסף את זה לפרוטוקול. אם הוא לא רואה את אחד הקווים המהירות שיחזיר תהיה .0

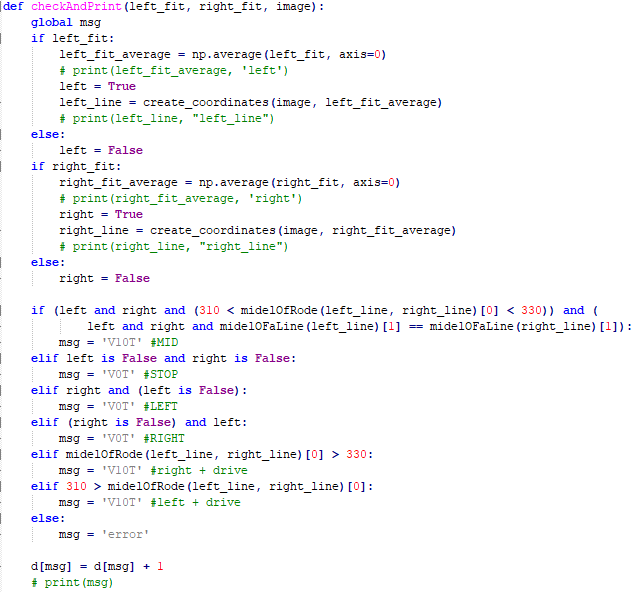
[picture p44: figure]

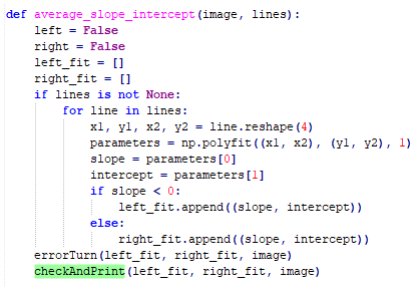
[picture p45: figure]

הפונקציה
average_slope_intercept
מחשבת את המדרון ואת
הקווים ומפעילה את
הפונקציות errorTurn ו
.checkAndPrint

הפונקציה main היא הפונקציה הראשית של המחלקה ושם בהתחלה אנו מגדירים את המשתנים ופותחים את התקשורת שלנו.

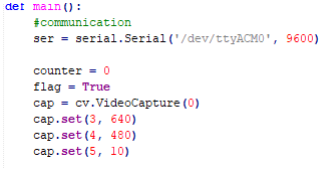
[picture p46: figure]

אחר כך אנו פותחים לולאה שתהיה אינסופית אלא אם המצלמה תכבה או כאשר נילחץ esc בהמשך אנו משתמשים בפונקציות כדי ליצור פילטרים ולהוסיף אינפורמציה.

כפי שניתן לראות בהמשך הפונקציה מחפשת אחר הקויים על ידי שימוש בפונקציה מה opencv הנקרא HoughLinesP. ואז היא מחשבת את ה lines_averaged אחרי חישובים הללו אנו מדפיסים ושולחים לארדרואינו את המהירויות כפי שצריך לשלוח )על פי הפרוטוקול( לבסוף אנו משתמשים בפונקציה showImages כדי להראות את התמונות.

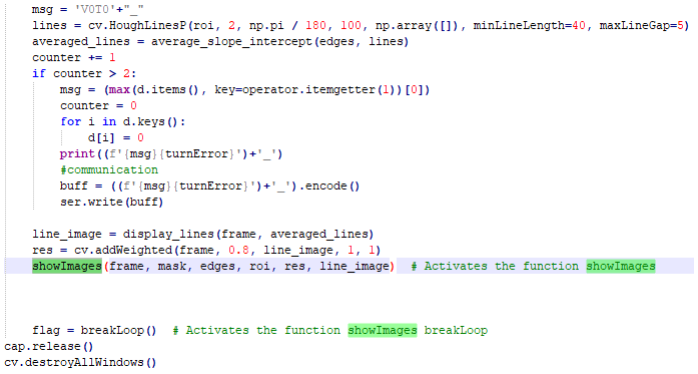
[picture p47: figure]

# רפלקציה-נתנאל

העבודה בפרויקט והמחקר שלו היה מיוחד,מעניין, קשה, ומעייף. אני בהתחלה העלתי רעיונות אחרים לפרויקט והתחלתי לחקור עליהם אך גיליתי שהם לא מתאימים לפרויקט בסדר גודל כזה אז חשבנו על פרויקט ואני רציתי לעבוד עם חומרה בגלל שאני התעסקתי עם חומרה בעבר וזה חומר שמעניין אותי ובסוף הגענו להחלטה לעשות מכונית שמזה את השוליים. כשהתחלנו הרגשתי עניין בגלל עיבוד תמונה זה חומר חדש בשבילי ובאמצע הפרויקט הרגשתי בלי מוטיבציה אך לעומת כל העומס סיימתי לעבוד על העיבוד תמונה והתחלנו לעבוד על הרובוט ולבסוף הרגשתי לחץ כי הפרויקט הרגיש לא מוכן )החלקים של הפרויקט עבדו איך כשילוב זה השתבש ( אבל כאשר הוא עבד הרגשתי שמחה.

הכלים שקיבלתי הם: עמידה בזמנים, עבודה בלחץ, עבודה עם חשמל ואלקטרוניקה, עבודה עם מנועים, עבודה עם עיבוד תמונה ודרך לחקור אלגוריתמים ונוסחאות מסובכות. כלים הללו אני ישתמש בשאר החיים שלי.

אם הייתי מתחיל היום את הפרויקט הייתי מפצל אותו לשני פרויקטים שונים הראשון הוא חיקוי של מוביליט על ידי עיבוד תמונה ותמרורים ולמידת מכונה. והשני שהוא רובוט אשר נישלת בצורה אלחוטית מהמחשב על ידי בלוטוס או wifi ולמחשב היה שלט ששולח את הנתונים של התזוזה למחשב. כדי שהעבודה הייתה יעילה יותר הייתי צריך להגביל את הזמן בין המחקר לעבודה ולקבוע מטרות ברורות ומפורטות לגבי הפרויקט.

אחד הדברים שסיבכו את הפרויקט היה הקורונה בגלל שהפרויקט שלנו היה פיזי לא היינו יכולים להיפגש והמורה לא היה יכול להסביר אחד לאחד על הפרויקט ואני חושב שאם הינו במצב אחר הדרך לפרויקט היה יותר ברור ופשוט.

המסקנות שלי מהפרויקט הם שכול פרויקט יהיה מפחיד ומסובך בהתחלה אך אם תשקיעו את הזמן ותיבחר פרויקט שמעניין אותך אך לבסוף הפרויקט היה קל ולא מסובך.

# רפלקציה-אייל

בתחילת העבודה ממש התלהבתי מהרעיון שאנחנו עומדים לעשות רובוט שנוסע לבד אך ככל שעבר הזמן הבנתי שזה פרויקט לא קל שדורש המון המון ידע ,למזלי שותפי לפרוייקט מכיר את העולם האלקטרוני לפני וממש הסביר לי כמו שצריך. לבסוף בשלבי הסיום הרגשתי הנאה מכיוון שסיימנו בהצלחה ושהצלחנו להתגבר על הקשיים.

במהלך העבודה על הפרוייקט רכשתי ידע בעולם האלקטרוניקה ולמדתי עוד תוכנות עיבוד שלא הכרתי כלל.
האתגרים שעמדו בפנינו הם בניית הרובוט עצמה ולמידת המכונה דרך המחשב ,בנוסף עשינו את הפרויקט בתקופת הקורונה כך שחלק גדול מאוד מהזמן עבדנו עם המורה דרך הזום וגם כך לא יכולתי להיפגש עם נתנאל חברי לקבוצה לעבוד איתו אחד ליד השני.

המסקנות שלי מהפרוייקט הם שהייתי צריך לקחת משחק מחשב במקור מידע ותוכנות שאני מכיר לפני ולא ללמוד מהתחלה את כל התוכנות והאלקטרוניקה. אני חושב שעבודה הייתה יותר יעילה אם היינו מסדרים את הזמן שלנו אחרת טיפה )יותר מסודר(

# ביבליוגרפיה

סירטון הסבר ללימוד ב opencv https://www.youtube.com/watch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 (https://www.youtube.com/watch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)

סירטון הסבר ללימוד ב ארדרואינו
https://www.youtube.com/watch?v=1R3fqSFCAjM

opencv documentation
https://docs.opencv.org/master/

Arduino Reference
https://www.arduino.cc/reference/en/

סירטון לימוד pid
https://www.youtube.com/watch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 %9E%D7%AA (https://www.youtube.com/watch?v=wkfEZmsQqiA&list=PLn8PRpmsu08pQBgjxYFXSsODEF3Jqmm-y)

# נספחים

הקוד של העיבוד תמונה:

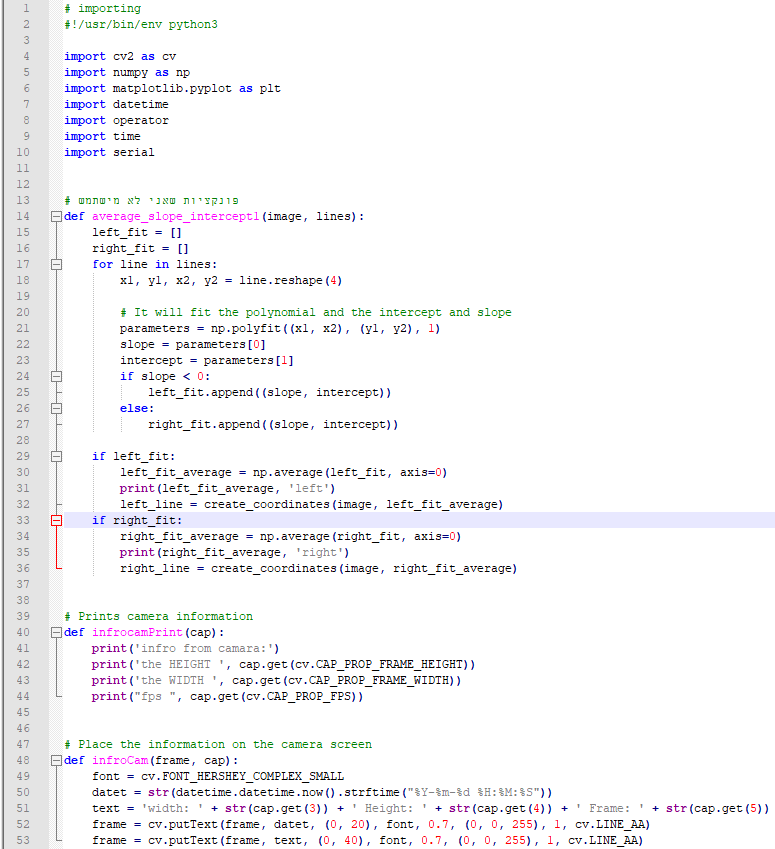
[picture p48: figure]

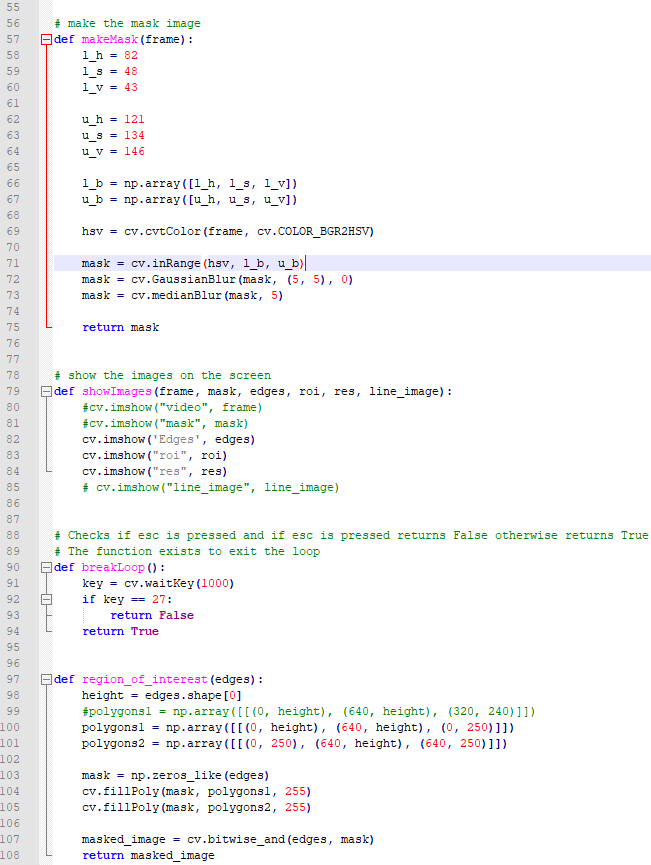
[picture p49: figure]
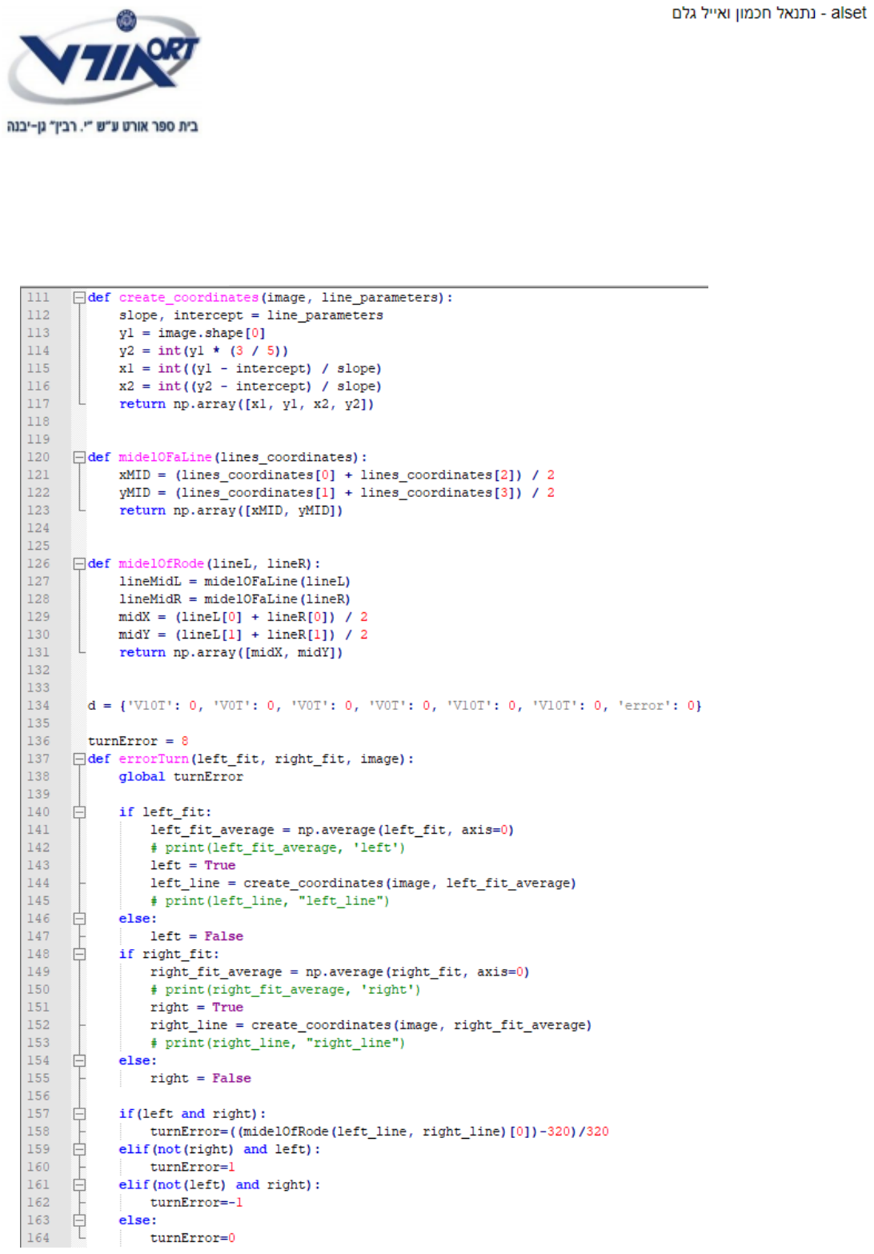
[picture p50: page 41]

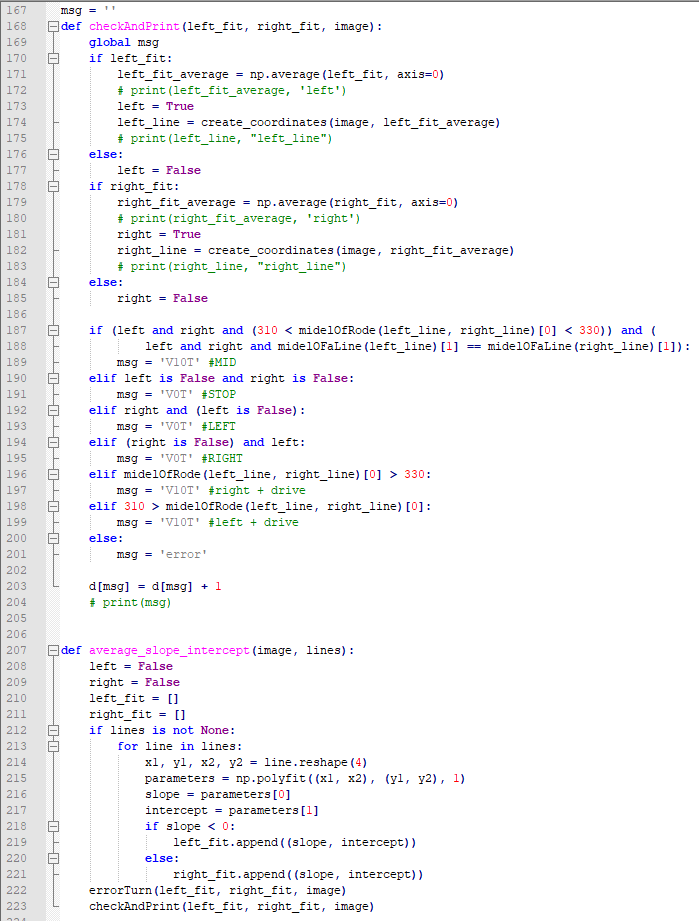
[picture p51: figure]

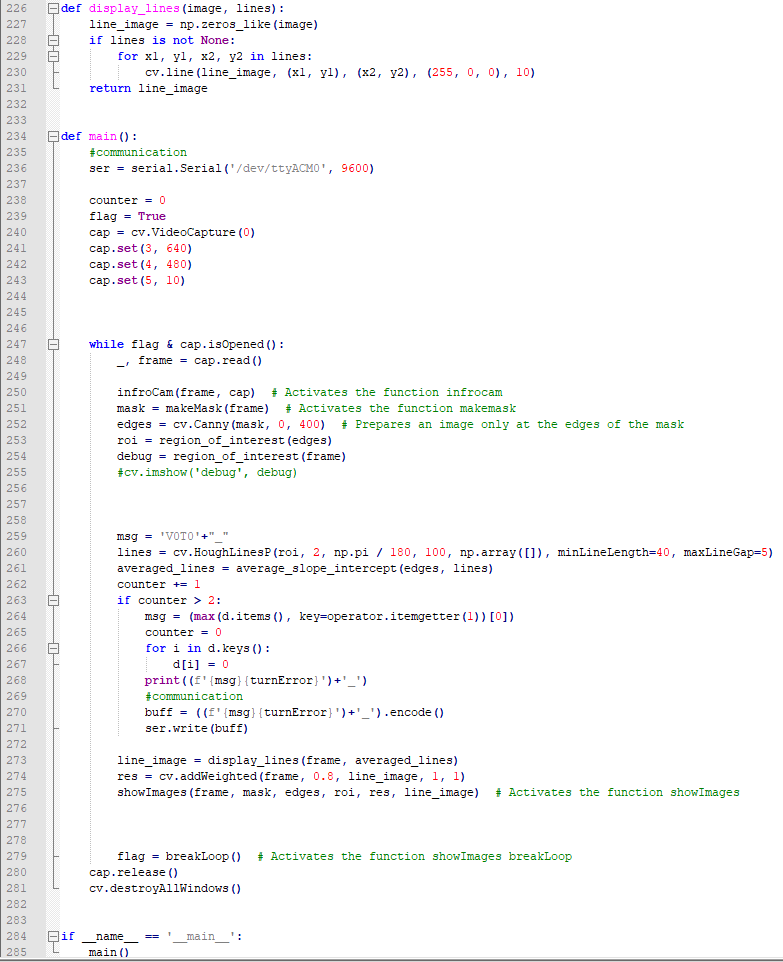
[picture p52: figure]

הקוד של הארדרואינו

Motors.h

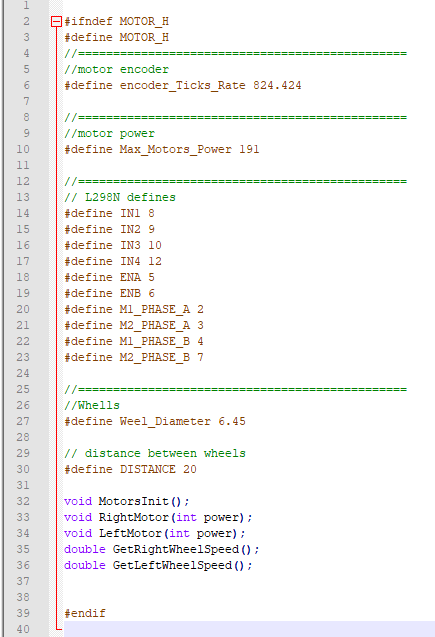
[picture p53: figure]

Motors.ino

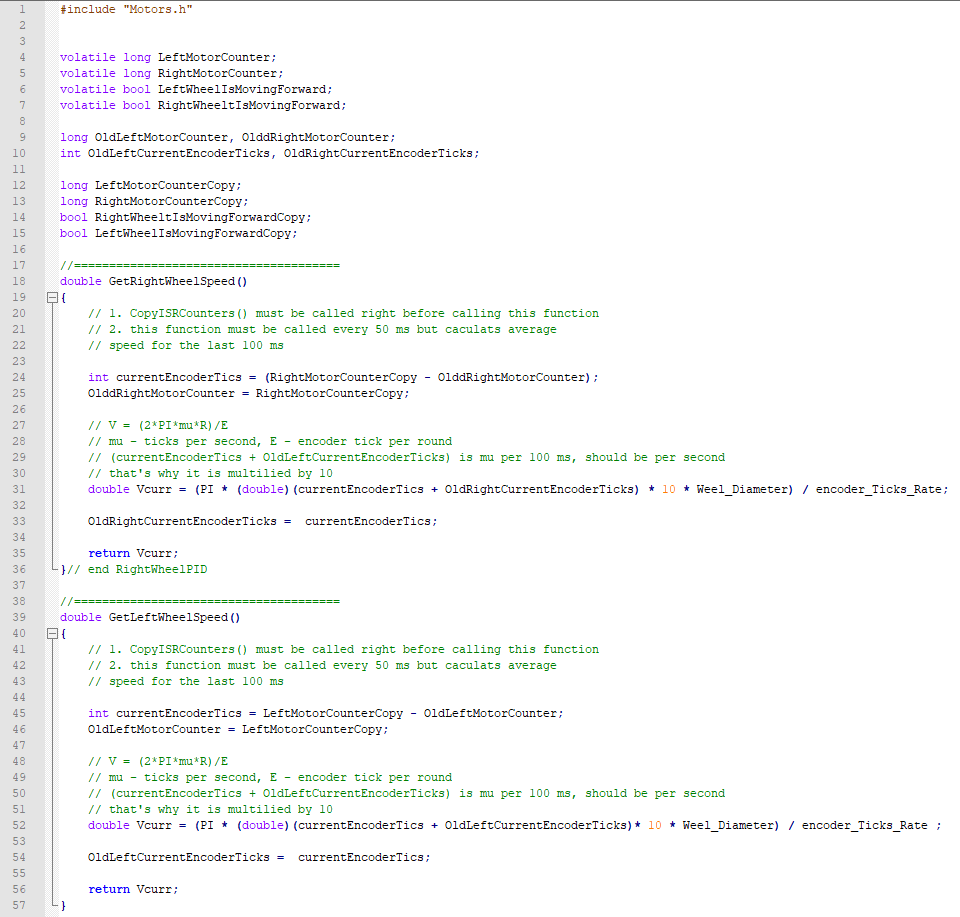
[picture p54: figure]

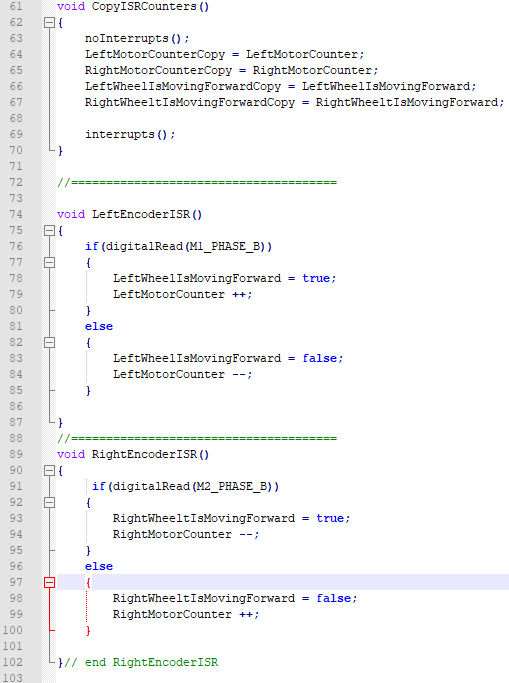
[picture p55: figure]
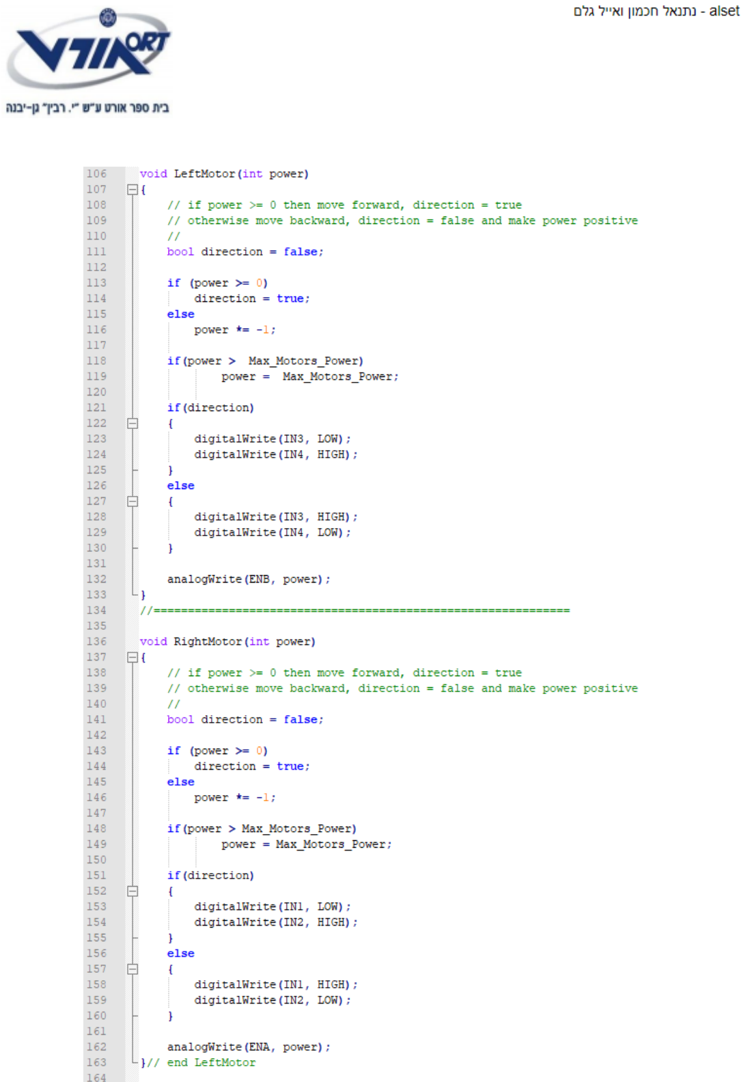
[picture p56: page 47]

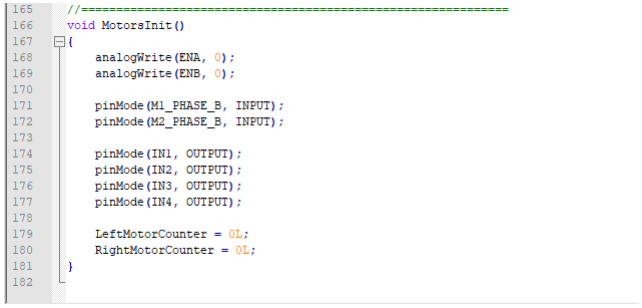
[picture p57: figure]

Main.ino

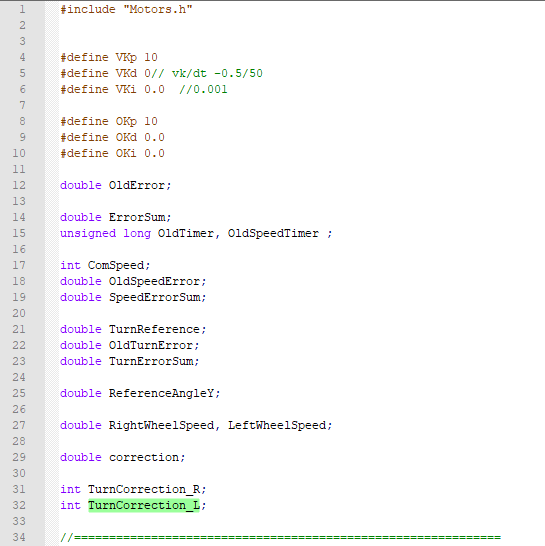
[picture p58: figure]

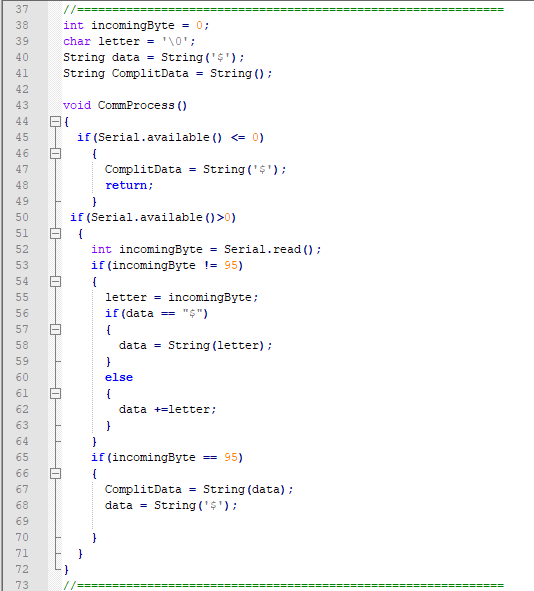
[picture p59: figure]

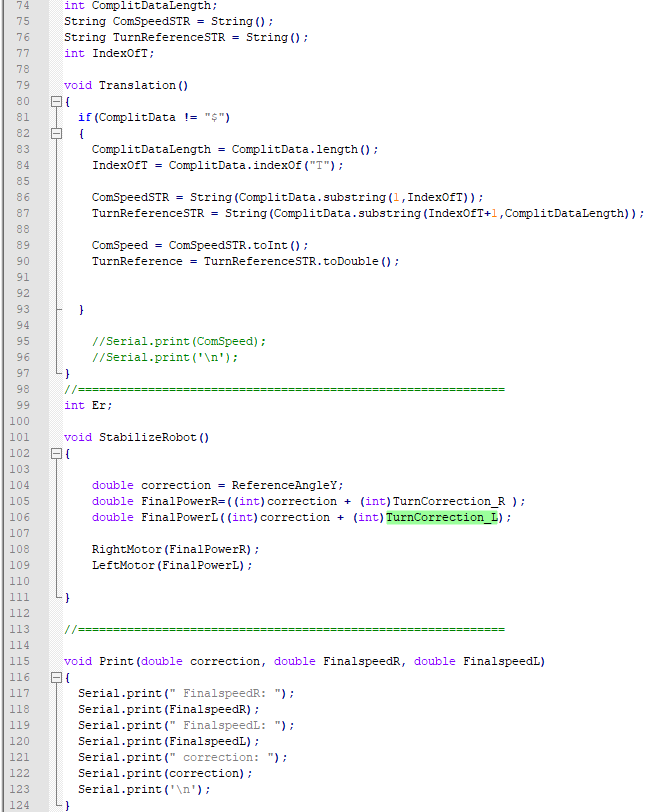
[picture p60: figure]

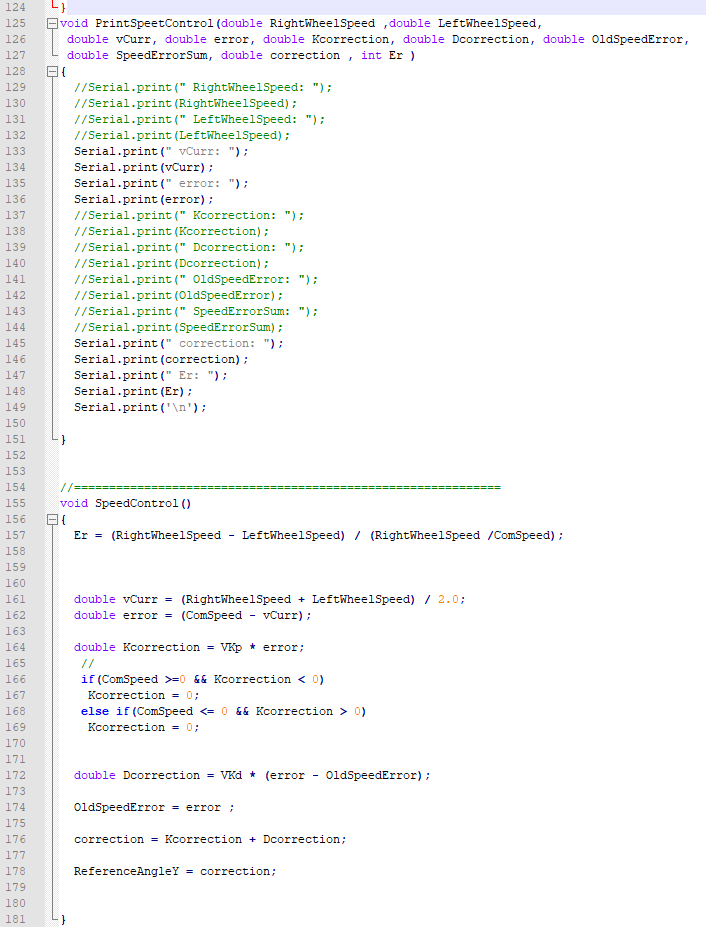
[picture p61: figure]

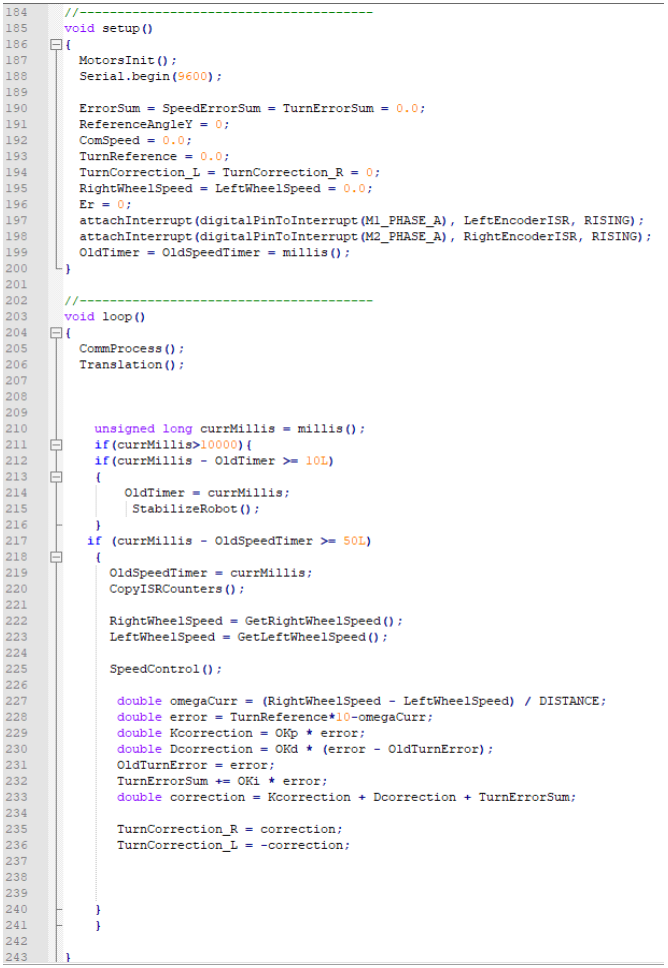
[picture p62: figure]
