netnis22/project-alset/Schematic_poject_car_2021-01-17.png

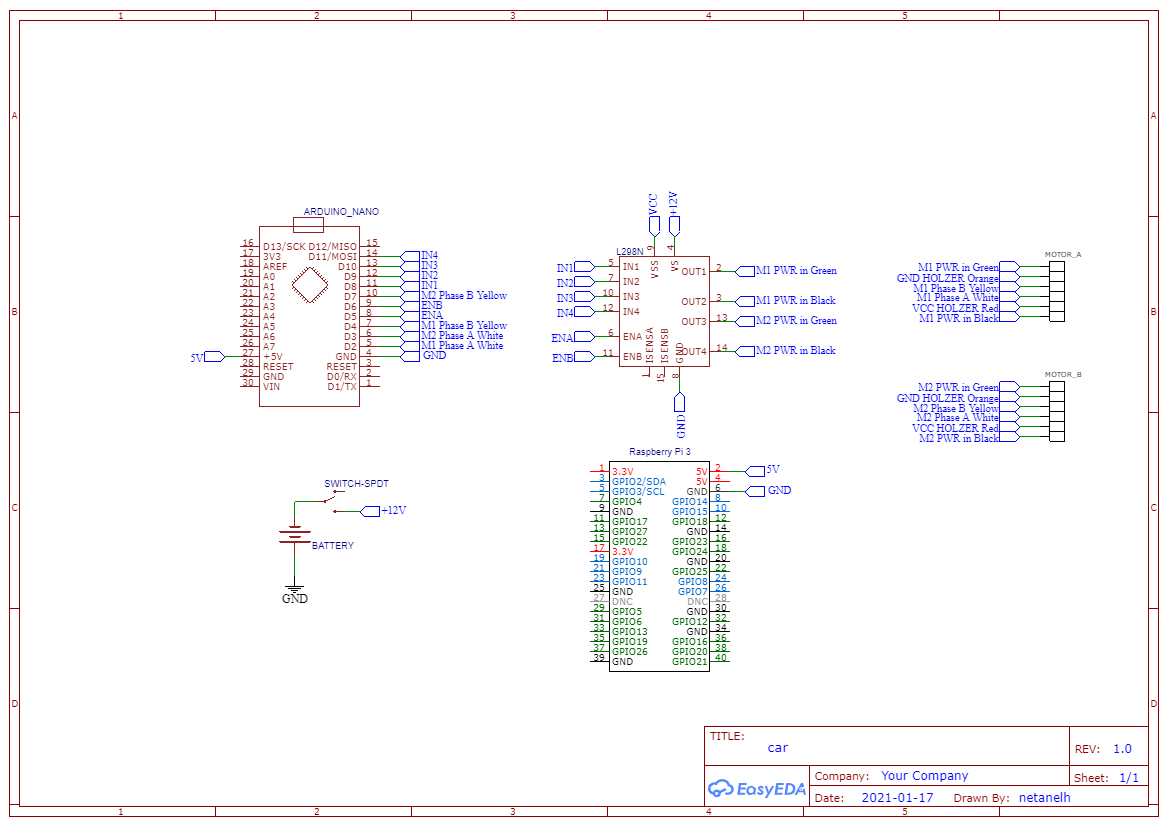
Schematic_poject_car_2021-01-17.png
