netnis22/project-alset/ללא שם2.png

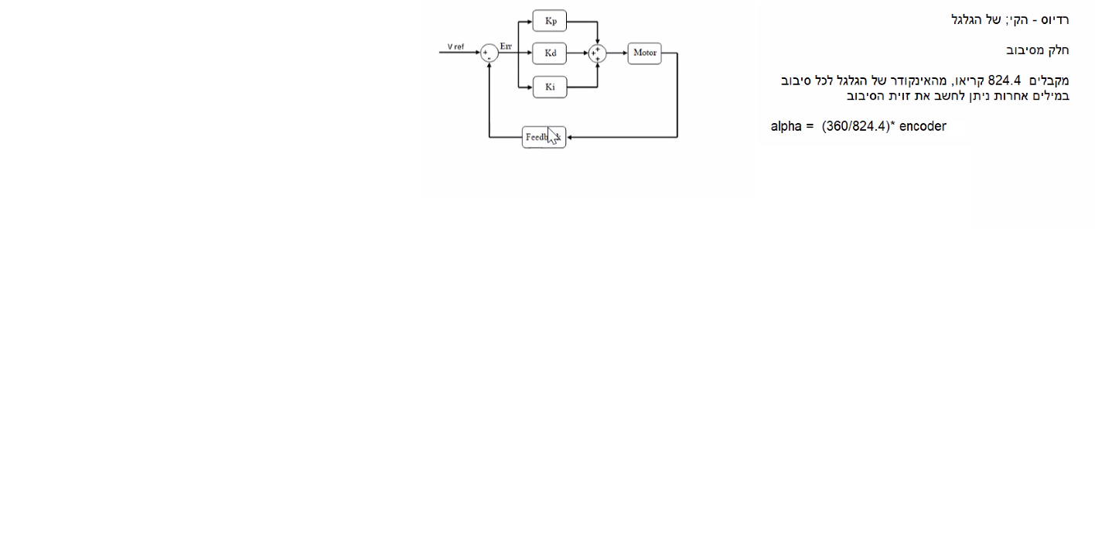
ללא שם2.png
