netnis22/project-alset/ללא שם.png

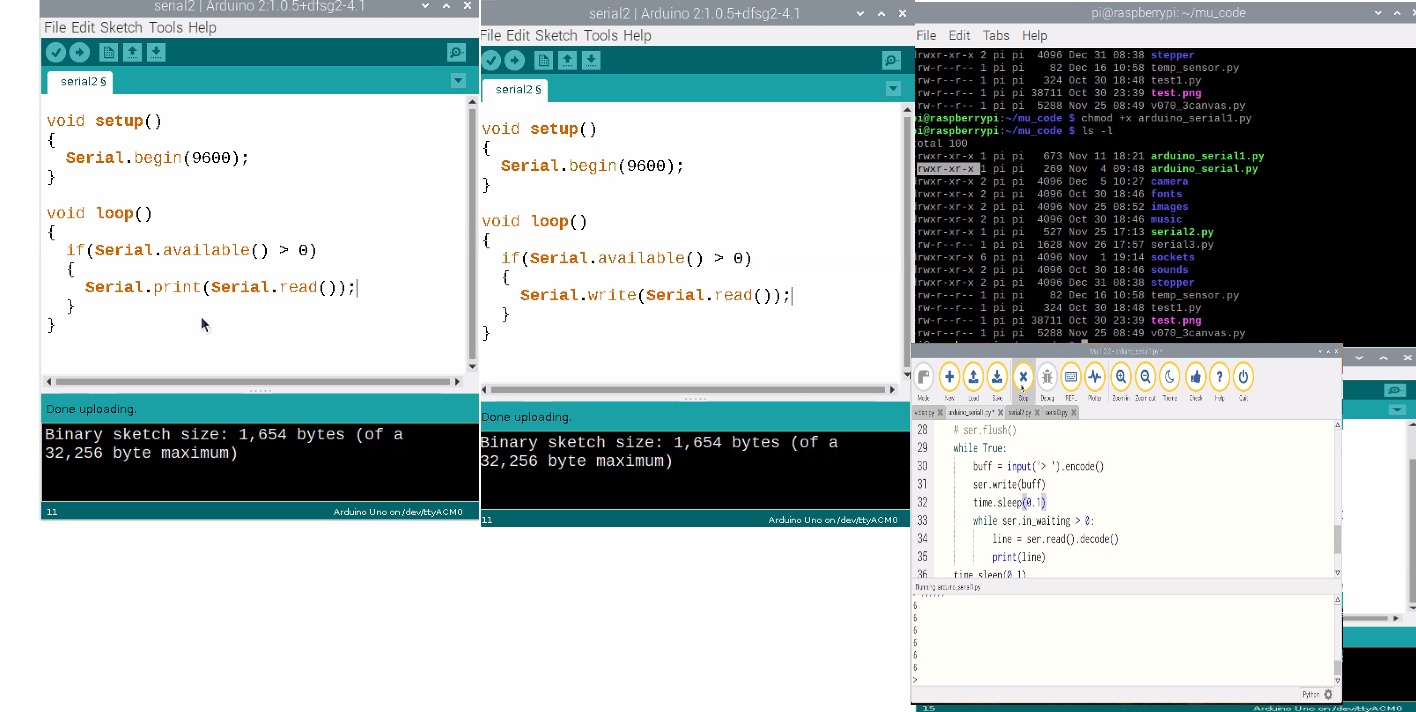
ללא שם.png
