netnis22/project-alset/תמונות פרויקט/הקוד עצמו בישביל הרצא.png

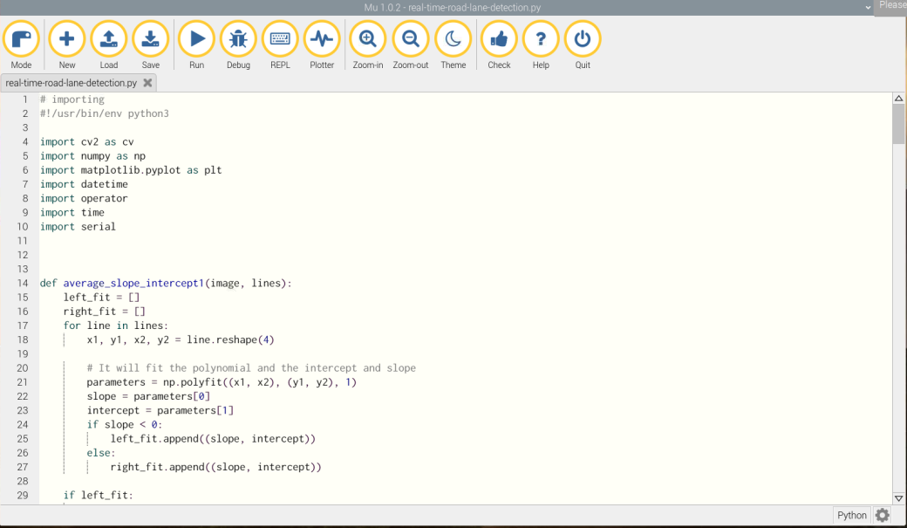
תמונות פרויקט/הקוד עצמו בישביל הרצא.png
