netnis22/project-alset/תמונות פרויקט/שולחן עבודה.png

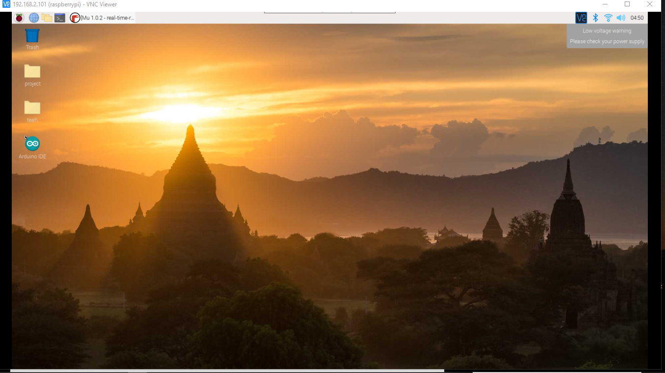
תמונות פרויקט/שולחן עבודה.png
