netnis22/project-alset/תמונות פרויקט/תיקיית הקוד של הכביש.png

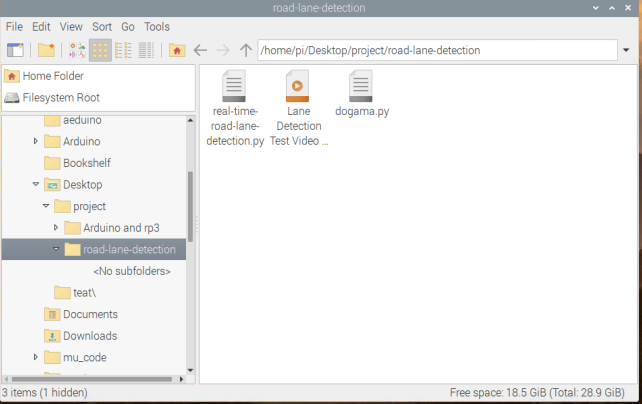
תמונות פרויקט/תיקיית הקוד של הכביש.png
