netnis22/project-alset/תמונות פרויקט/תיקיית פרויקט.png

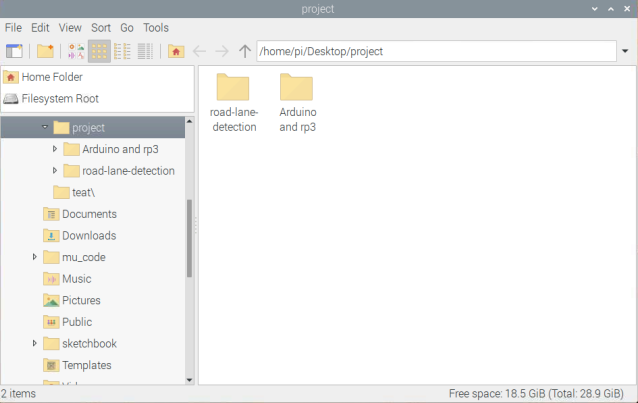
תמונות פרויקט/תיקיית פרויקט.png
