netnis22/project-alset/test 1/rodeFinal.jpg

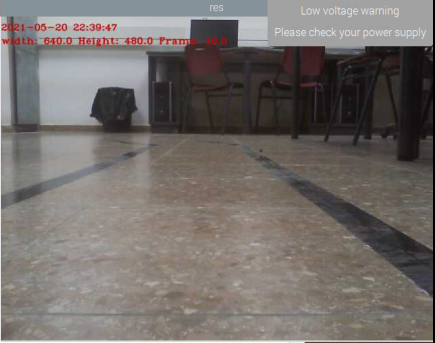
test 1/rodeFinal.jpg
