netnis22/project-alset/test 2/image_1.jpg

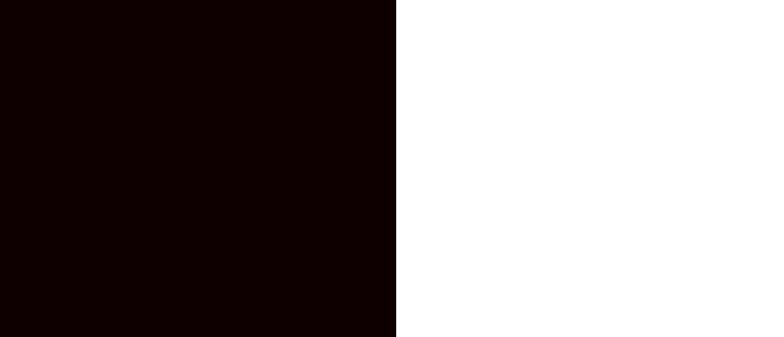
test 2/image_1.jpg
