netnis22/project-alset/Schematic_poject_car_2021-01-28.pdf

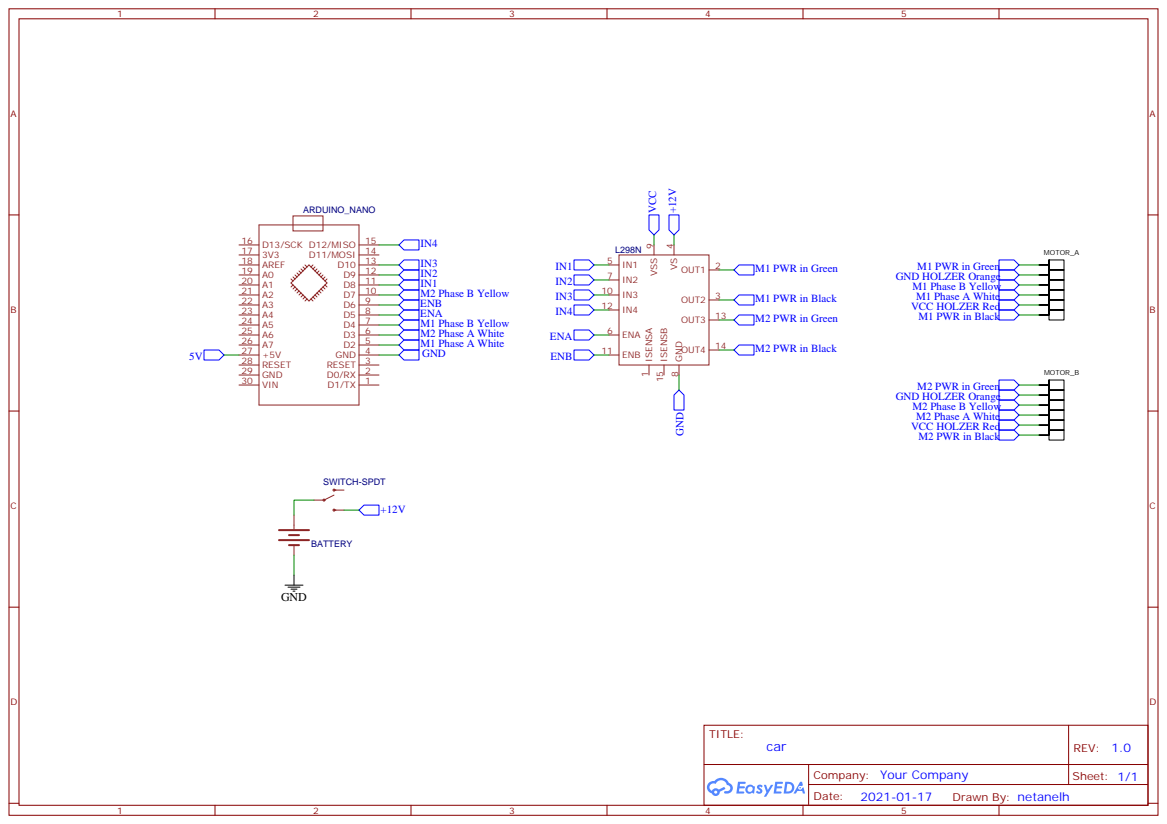
[picture p72: page 1]
