netnis22/project-alset/SelfBalancingSW/Schematic_SelfBalancing_2021-01-11.pdf

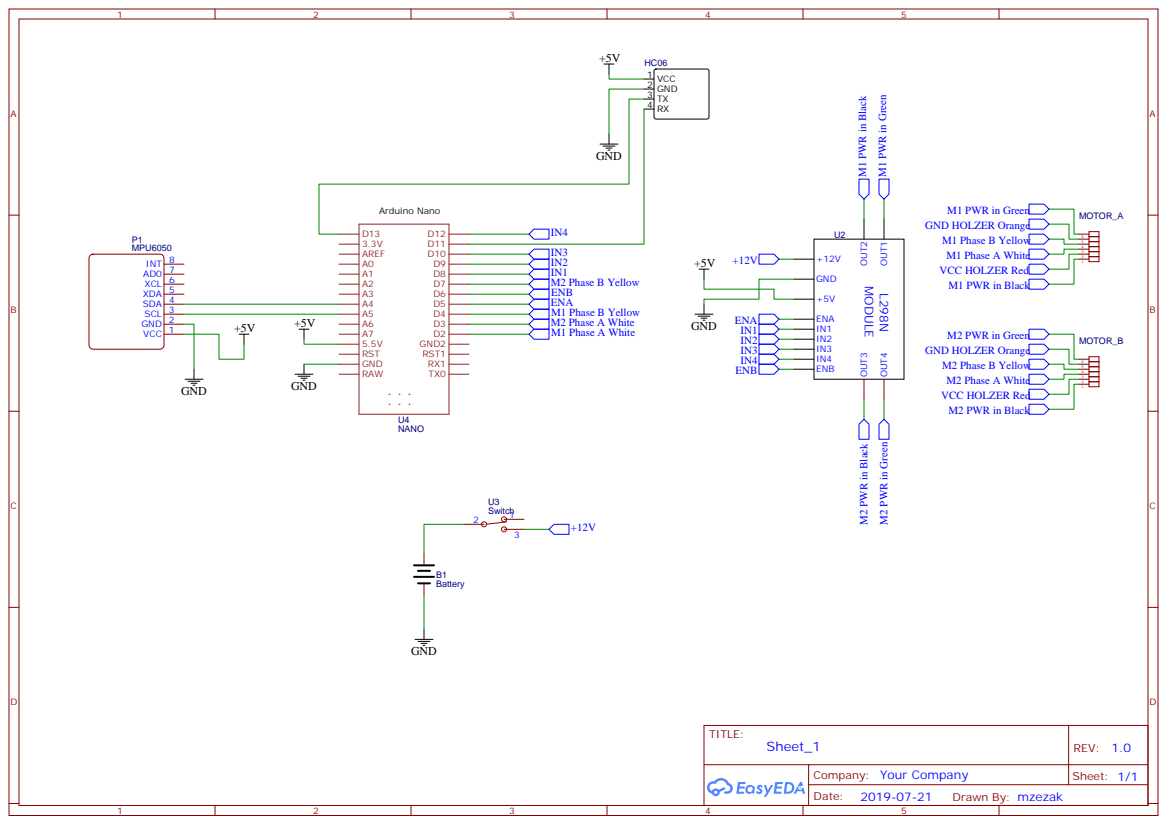
[picture p73: page 1]
