netnis22/project-alset/SelfBalancingSW/04-BalancingTestWithKalman/TestKalman/mpuangle.ino

#include <Wire.h>
#include <Kalman.h> // Source: https://github.com/TKJElectronics/KalmanFilter
#include "mpuangle.h"

Kalman kalmanY;

/* IMU Data */
double accX, accY, accZ;
double gyroX, gyroY, gyroZ;

double compAngleY;
double kalAngleY;

uint32_t timer;
uint8_t i2cData[14]; // Buffer for I2C data

//=============================================================
bool MPUangleInit()
{
    Wire.begin();
   
#if ARDUINO >= 157
    Wire.setClock(400000UL); // Set I2C frequency to 400kHz
#else
    TWBR = ((F_CPU / 400000UL) - 16) / 2; // Set I2C frequency to 400kHz
#endif

/* Table Taken from https://www.i2cdevlib.com/
 *  http://github.com/jrowberg/i2cdevlib    in the Arduino/MPU6050 directory
 *          |   ACCELEROMETER    |           GYROSCOPE
 * DLPF_CFG | Bandwidth | Delay  | Bandwidth | Delay  | Sample Rate
 * ---------+-----------+--------+-----------+--------+-------------
 * 0        | 260Hz     | 0ms    | 256Hz     | 0.98ms | 8kHz
 * 1        | 184Hz     | 2.0ms  | 188Hz     | 1.9ms  | 1kHz
 * 2        | 94Hz      | 3.0ms  | 98Hz      | 2.8ms  | 1kHz
 * 3        | 44Hz      | 4.9ms  | 42Hz      | 4.8ms  | 1kHz
 * 4        | 21Hz      | 8.5ms  | 20Hz      | 8.3ms  | 1kHz
 * 5        | 10Hz      | 13.8ms | 10Hz      | 13.4ms | 1kHz
 * 6        | 5Hz       | 19.0ms | 5Hz       | 18.6ms | 1kHz
 * 7        |   -- Reserved --   |   -- Reserved --   | Reserved
 **/
 
    i2cData[0] = 7; // Set the sample rate to 1000Hz - 8kHz/(7+1) = 1000Hz
    i2cData[1] = 0x05; // MPU address 0x1A, Disable FSYNC and set filters and sampling rate (the above table)
    i2cData[2] = 0x00; // Set Gyro Full Scale Range to ±250deg/s
    i2cData[3] = 0x00; // Set Accelerometer Full Scale Range to ±2g
    while (i2cWrite(0x19, i2cData, 4, false)); // Write to all four registers at once
    while (i2cWrite(0x6B, 0x01, true)); // PLL with X axis gyroscope reference and disable sleep mode

    while (i2cRead(0x75, i2cData, 1));
    if (i2cData[0] != 0x68) 
    { // Read "WHO_AM_I" register
        //Serial.print(F("Error reading sensor"));
        return false;
    }

    delay(100); // Wait for sensor to stabilize

    /* Set kalman and gyro starting angle */
    while (i2cRead(0x3B, i2cData, 6));
    accX = (int16_t)((i2cData[0] << 8) | i2cData[1]);
    accY = (int16_t)((i2cData[2] << 8) | i2cData[3]);
    accZ = (int16_t)((i2cData[4] << 8) | i2cData[5]);


    double roll  = atan(accY / sqrt(accX * accX + accZ * accZ)) * RAD_TO_DEG;
    double pitch = atan2(-accX, accZ) * RAD_TO_DEG;


    kalmanY.setAngle(pitch); // Set starting angle
    compAngleY = pitch;
    
    timer = micros();
    return true;
} // end MPUangleInit

//=============================================================
void CalcYangle(double& KalY, double& CompY)
{
     /* Update all the values */
    while (i2cRead(0x3B, i2cData, 14));
    accX = (int16_t)((i2cData[0] << 8) | i2cData[1]);
    accY = (int16_t)((i2cData[2] << 8) | i2cData[3]);
    accZ = (int16_t)((i2cData[4] << 8) | i2cData[5]);
    
    gyroX = (int16_t)((i2cData[8] << 8) | i2cData[9]);
    gyroY = (int16_t)((i2cData[10] << 8) | i2cData[11]);
    gyroZ = (int16_t)((i2cData[12] << 8) | i2cData[13]);;

    double dt = (double)(micros() - timer) / 1000000; // Calculate delta time
    timer = micros();


    double roll  = atan(accY / sqrt(accX * accX + accZ * accZ)) * RAD_TO_DEG;
    double pitch = atan2(-accX, accZ) * RAD_TO_DEG;

    double gyroYrate = gyroY / 131.0; // Convert to deg/s


    // This fixes the transition problem when the accelerometer angle jumps between -180 and 180 degrees
    if ((pitch < -90 && kalAngleY > 90) || (pitch > 90 && kalAngleY < -90)) 
    {
        kalmanY.setAngle(pitch);
        compAngleY = pitch;
        kalAngleY = pitch;
    } 
    else
        kalAngleY = kalmanY.getAngle(pitch, gyroYrate, dt); // Calculate the angle using a Kalman filter

    compAngleY = 0.93 * (compAngleY + gyroYrate * dt) + 0.07 * pitch;  
    
    KalY = kalAngleY;
    CompY = compAngleY;
}// end CalcYangle
