netnis22/project-alset/(commit log)

2020-11-06 real-time-road-lane-detection
    i am programing real-time-road-lane-detection 0.1v
2021-01-14 add filder
    [speeds.xlsx]
2021-01-28 new elctric schematics
2021-01-28 Revert "add file"
    This reverts commit f1b4d242c92f272b373047e0ceb1f2e19d97e35d.
    [arduino_serial1.py, serial2.ino]
2021-02-07 Create ללא שם2.png
2021-03-28 pid-0.1 work?
2021-03-29 pid v0.2
2021-03-30 pid not mosha v0.1
2021-03-31 pid woeking v0.1
2022-02-14 Create ספר פרויקט.pdf
